P4ulBr4ndt/hellen-bremen/README.md

# Hellen-Bremen

**WIP. Untested.**

This is trying to be yet another HD ECU based on rusEFI.\
Commercial rusEFI based HD ECUs:\
https://www.nmstec.ca/product/hdrevb/ This seems to be the initial community development? 
https://impactwiringsolutions.com/ Commercial product
