P4ulBr4ndt/hellen-bremen/boards/hellenbremen-a/board/hellenbremen-a.png

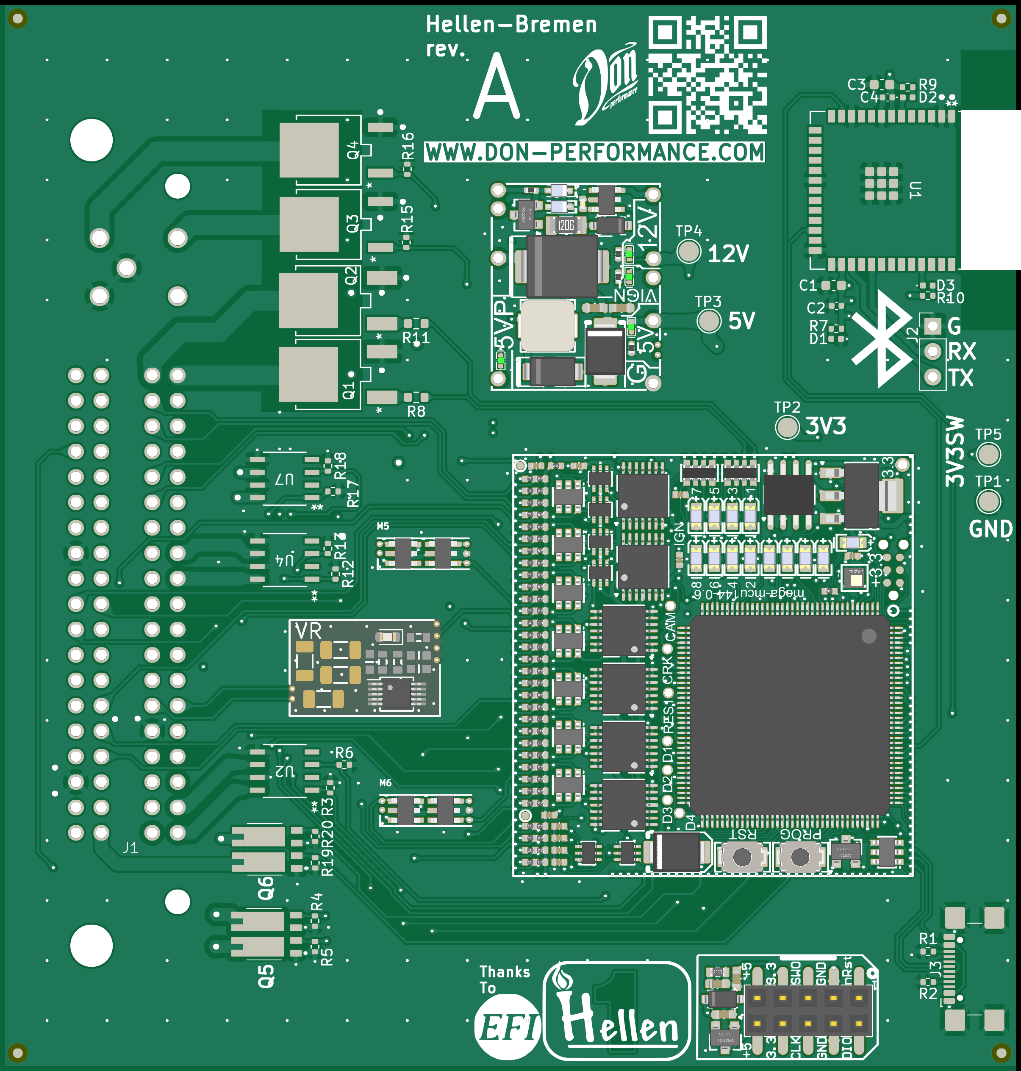
boards/hellenbremen-a/board/hellenbremen-a.png
