P4ulBr4ndt/hellen-bremen/boards/hellenbremen-a/board/misc/hellenbremen-a-bottom.png

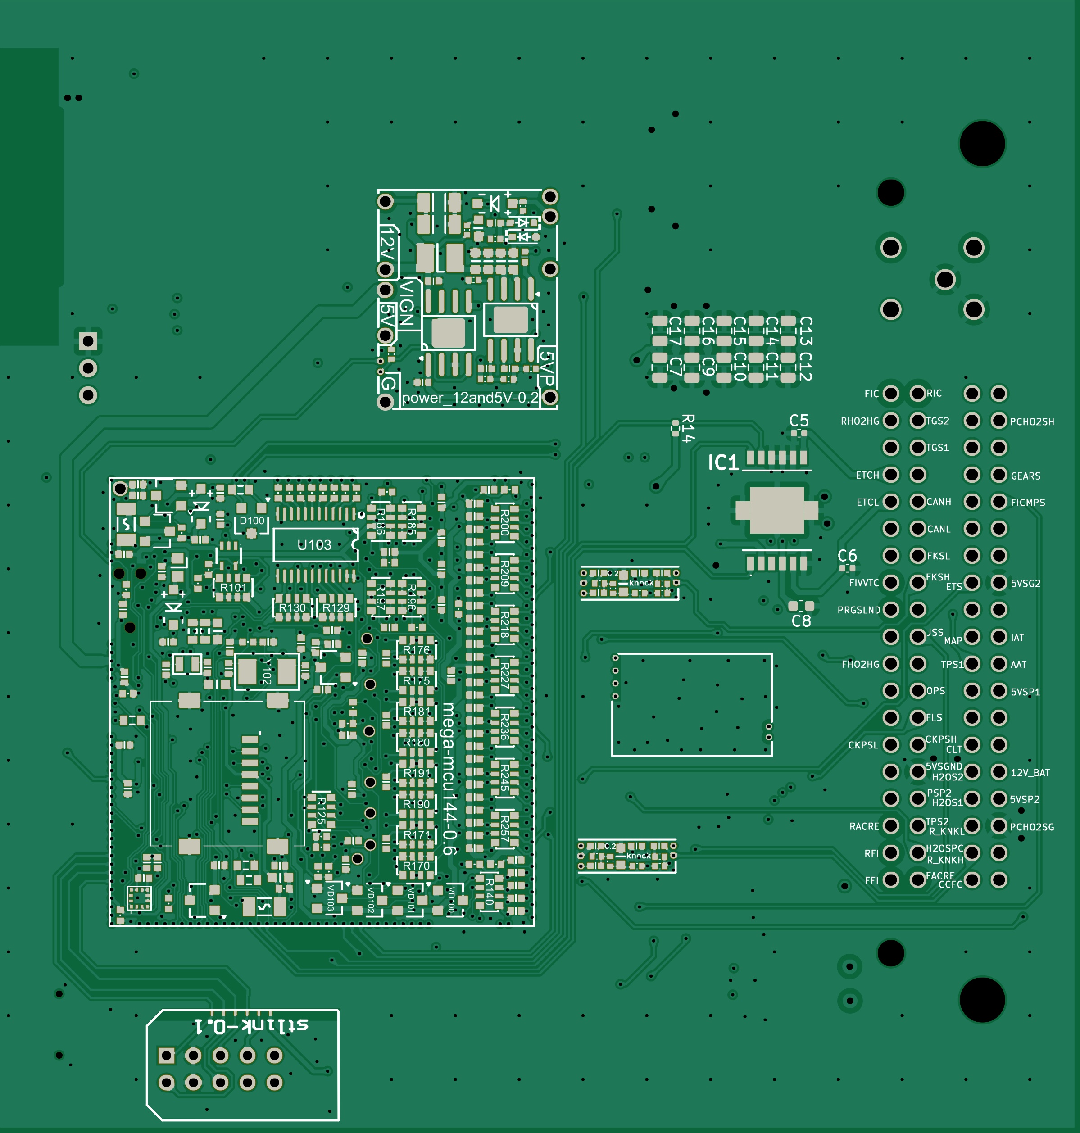
boards/hellenbremen-a/board/misc/hellenbremen-a-bottom.png
