P4ulBr4ndt/hellen-bremen/boards/hellenbremen-a/board/misc/hellenbremen-a-outline.png

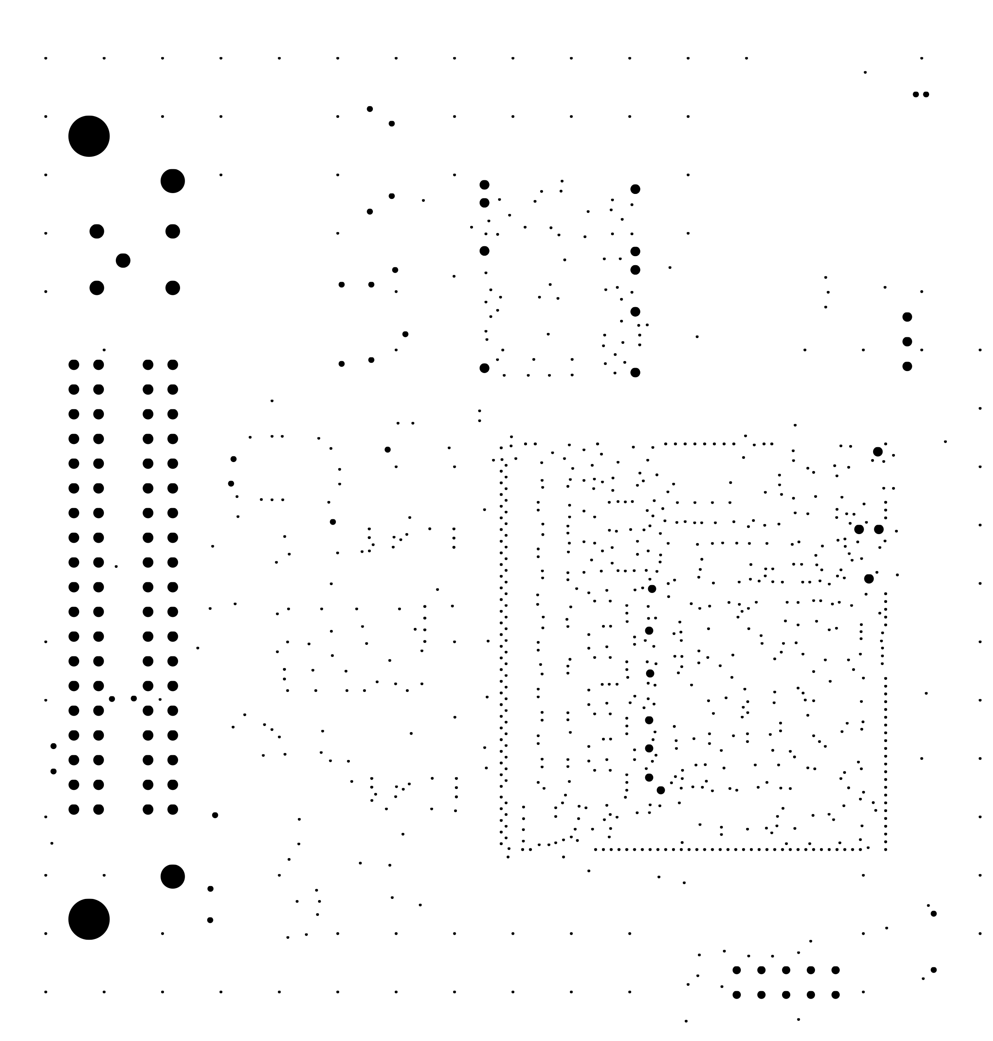
boards/hellenbremen-a/board/misc/hellenbremen-a-outline.png
