P4ulBr4ndt/hellen-bremen/boards/hellenbremen-c/board/misc/hellenbremen-c-components.png

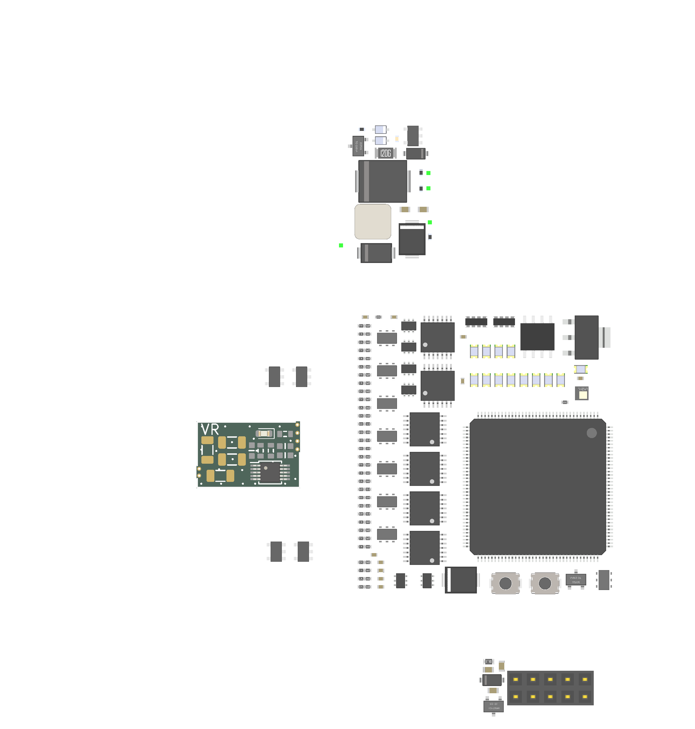
boards/hellenbremen-c/board/misc/hellenbremen-c-components.png
