P4ulBr4ndt/hellen-bremen/boards/hellenbremen-c/frame/bremen-schematic.pdf

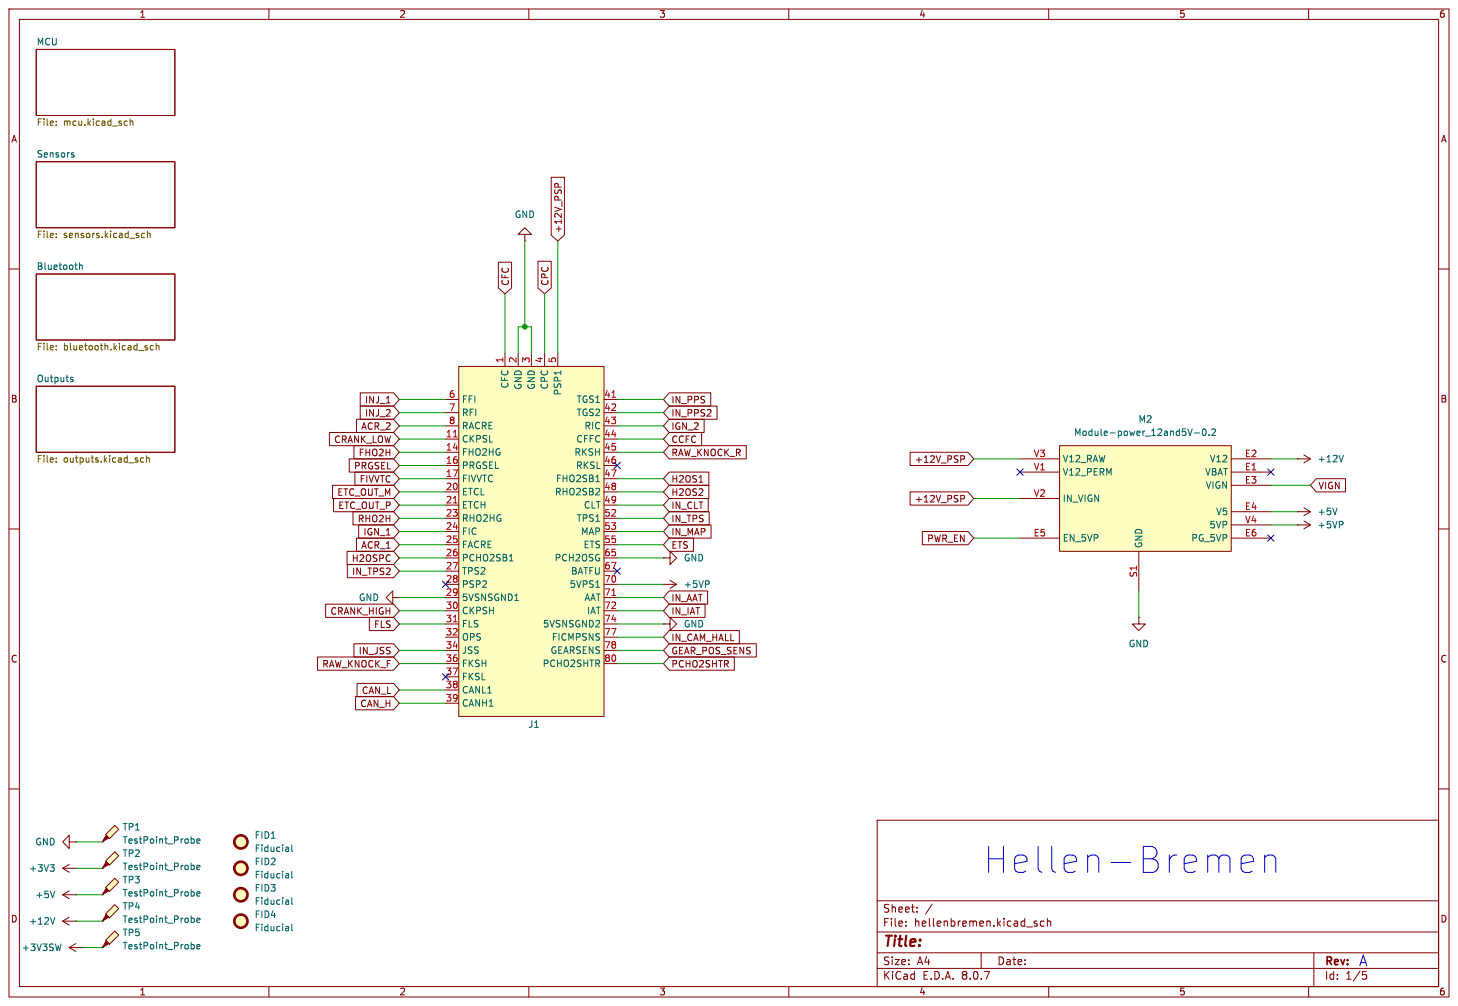
[picture p6: page 1]

File: mcu.kicad_sch Bluetooth File: bluetooth.kicad_sch Outputs File: outputs.kicad_sch Sensors File: sensors.kicad_sch

1 CKPSL 11 FHO2HG 14 PRGSEL 16 FIVVTC 17 GND

2 ETCL 20 ETCH 21 RHO2HG 23 FIC 24 FACRE 25 PCHO2SB1 26 TPS2 27 PSP2 28

5 TPS1 52 MAP 53 ETS 55 FFI 6 PCH2OSG 65 BATFU 67 RFI 7

4 TGS1 41 TGS2 42 RIC 43 CFFC 44 RKSH 45 RKSL 46 FHO2SB1 47 RHO2SB2 48 CLT 49 PSP1

Id: 1/5 Title: File: hellenbremen.kicad_sch Sheet: /

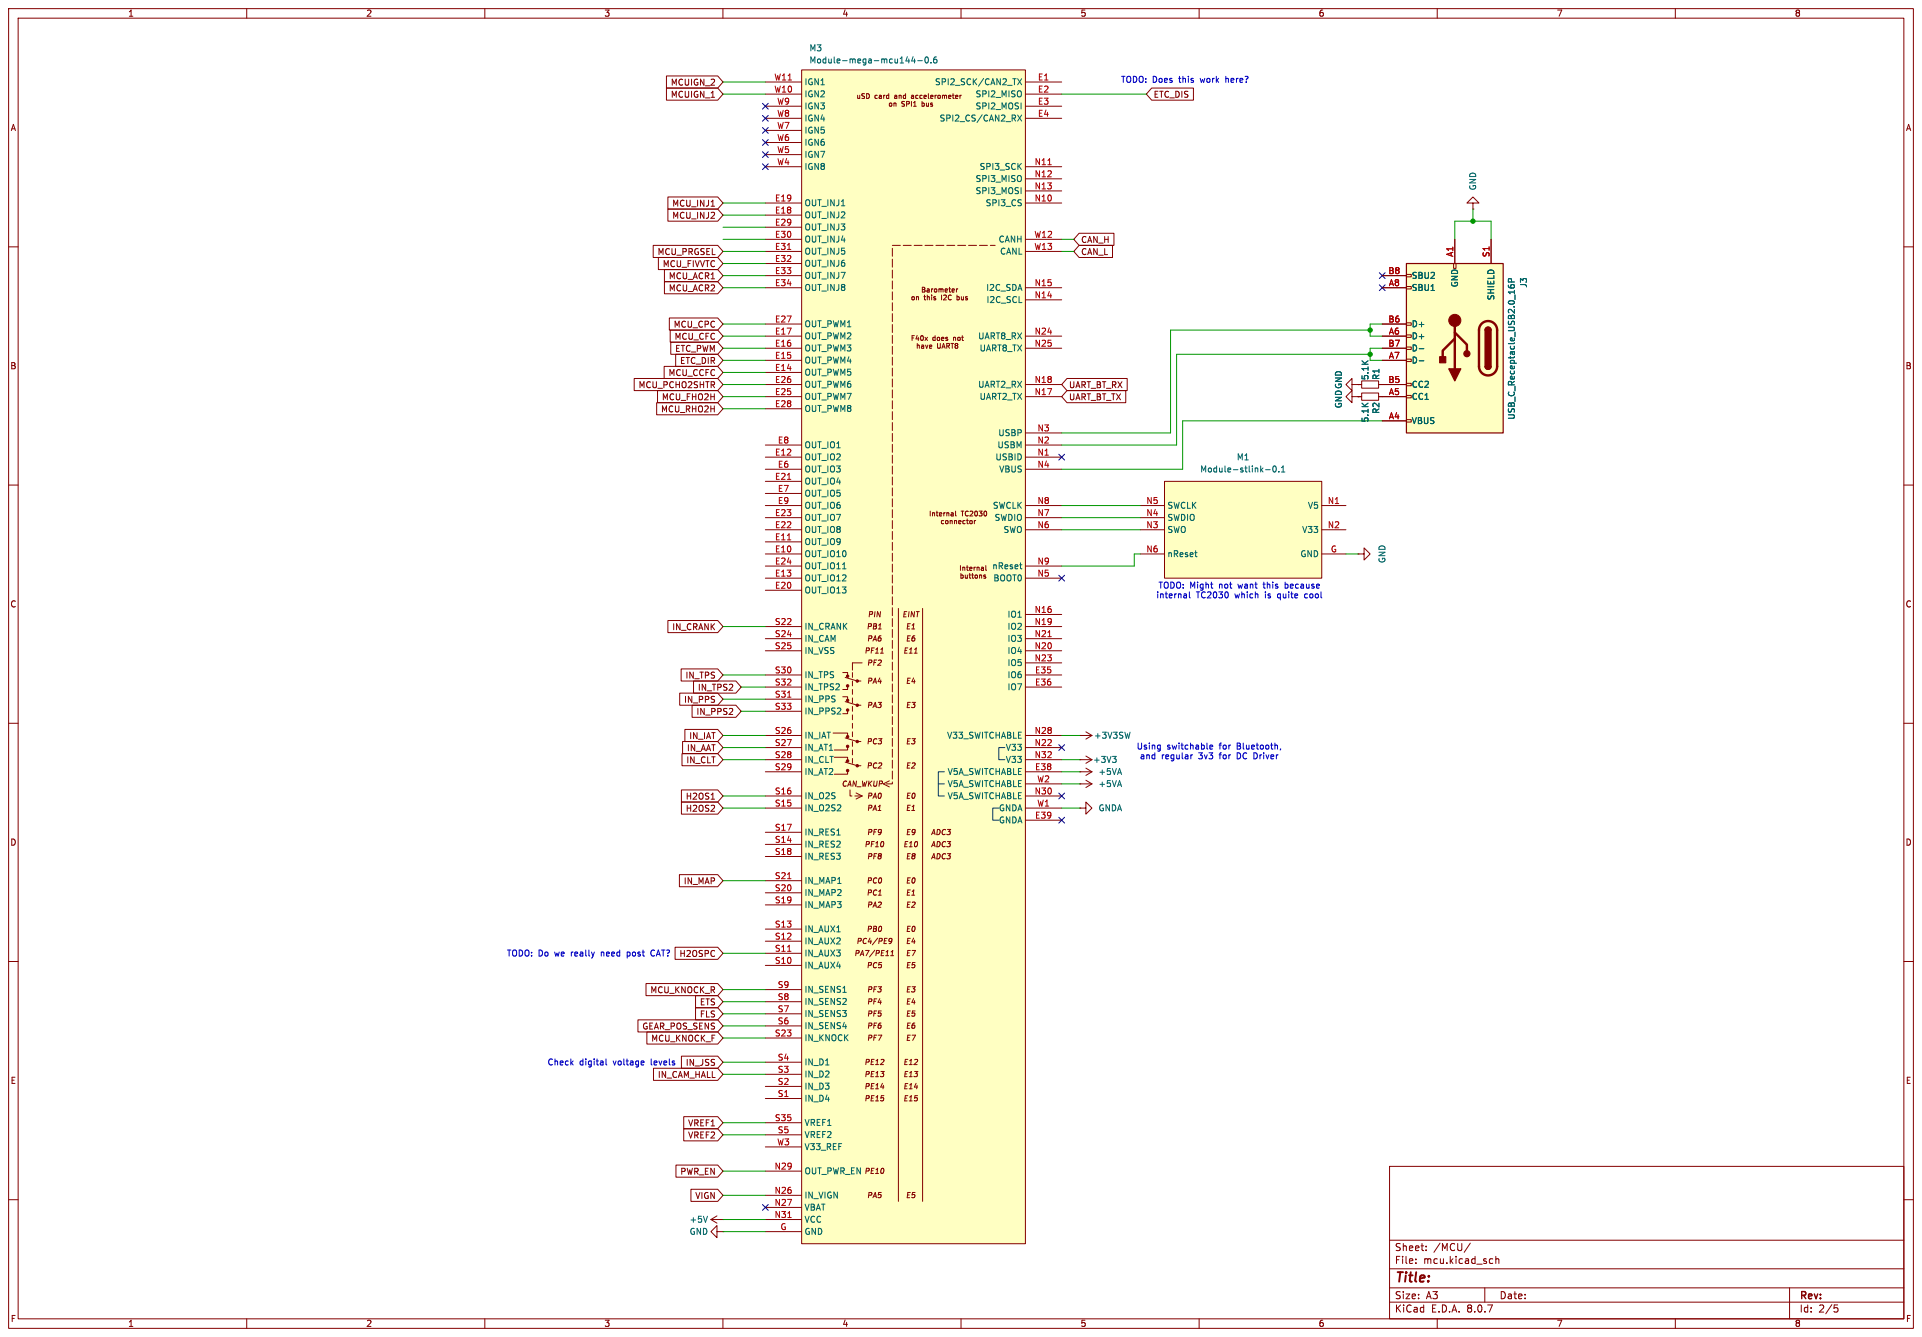
[picture p7: page 2]

TODO: Does this work here? TODO: Might not want this because
connector PA0 PA1 PA2 PA3 PA4

Id: 2/5 Title: File: mcu.kicad_sch Sheet: /MCU/

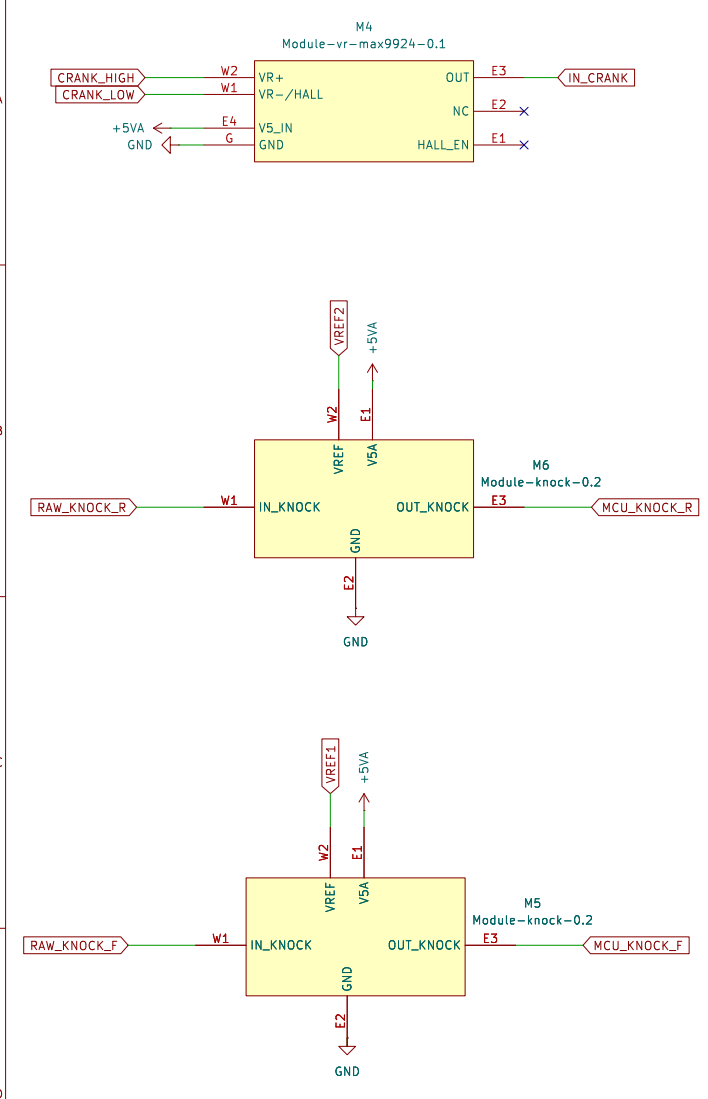
[picture p8: page 3]

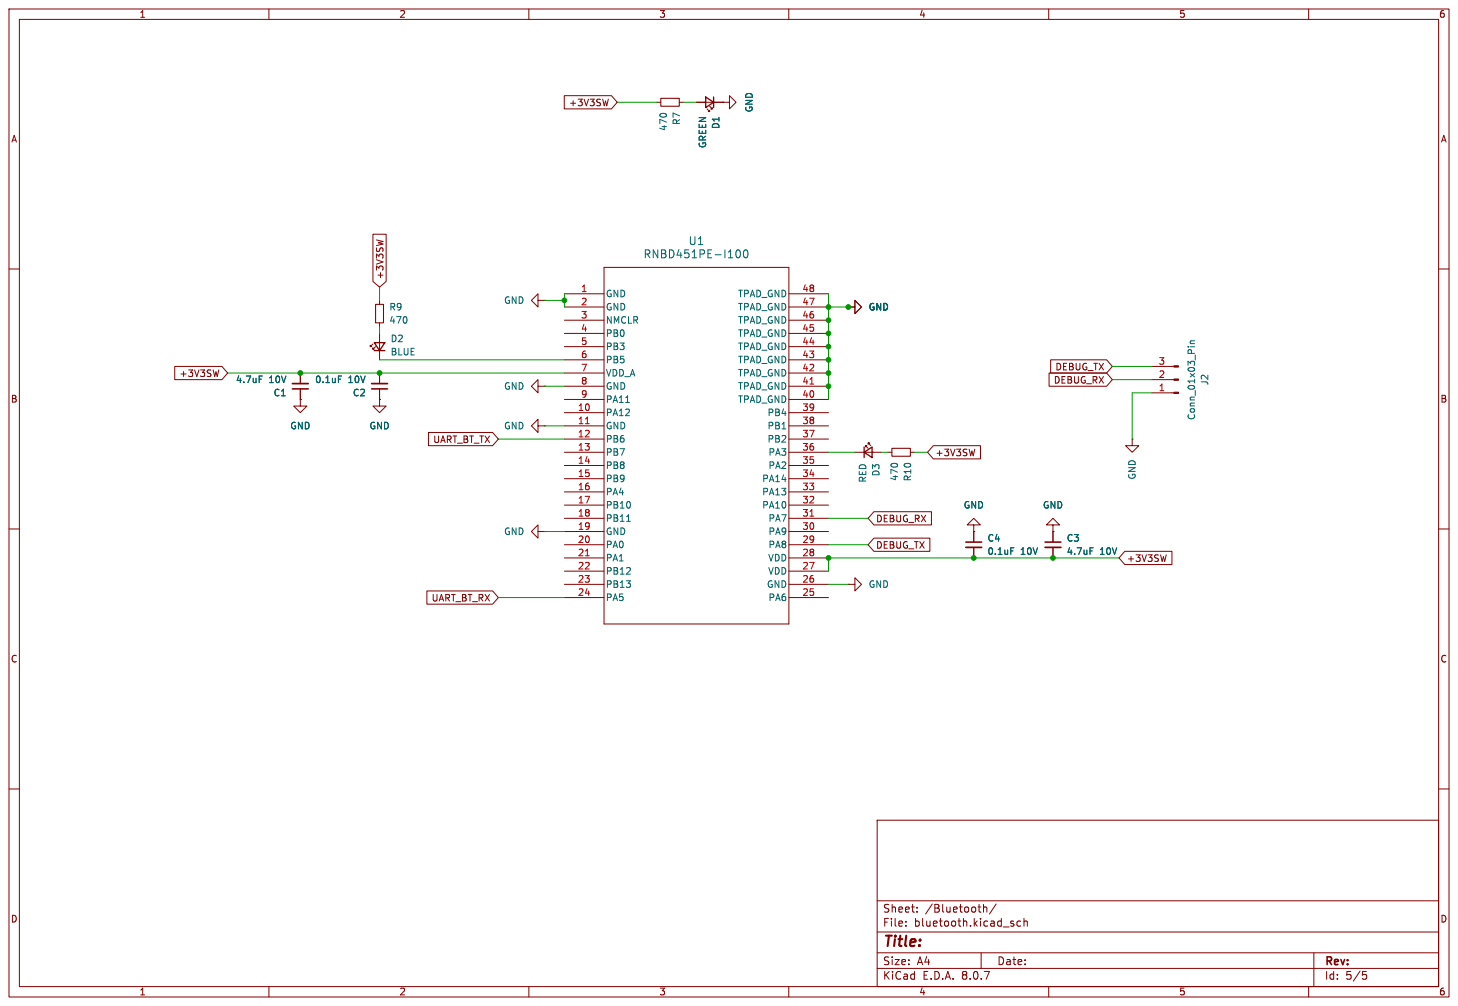
[picture p9: page 4]

Id: 5/5 Title: File: bluetooth.kicad_sch Sheet: /Bluetooth/ GND

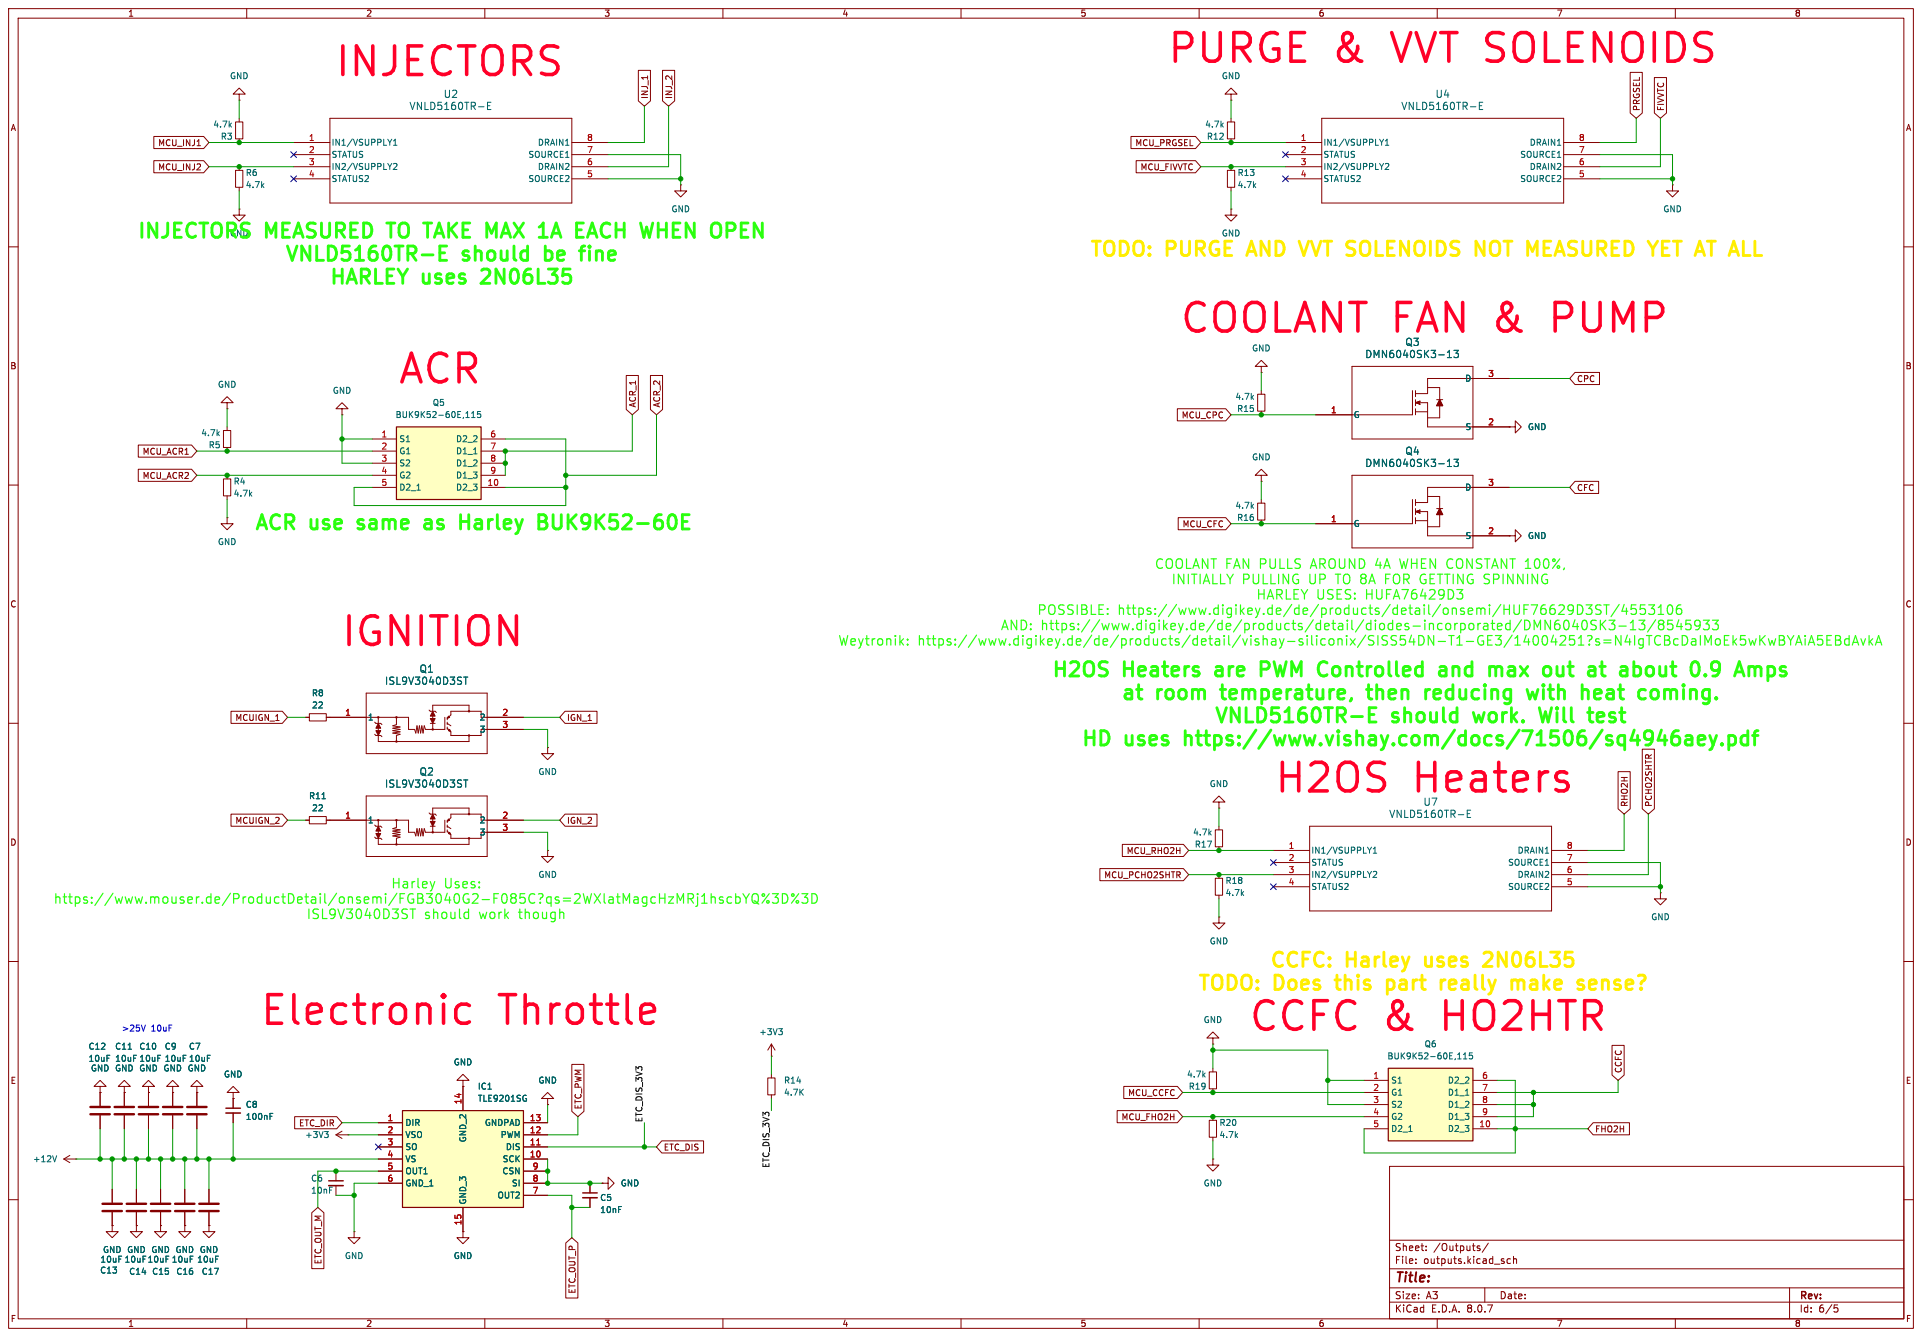
[picture p10: page 5]

INJECTORS MEASURED TO TAKE MAX 1A EACH WHEN OPEN

TODO: PURGE AND VVT SOLENOIDS NOT MEASURED YET AT ALL
COOLANT FAN & PUMP

COOLANT FAN PULLS AROUND 4A WHEN CONSTANT 100%,
INITIALLY PULLING UP TO 8A FOR GETTING SPINNING

POSSIBLE: https://www.digikey.de/de/products/detail/onsemi/HUF76629D3ST/4553106
AND: https://www.digikey.de/de/products/detail/diodes-incorporated/DMN6040SK3-13/8545933
H2OS Heaters are PWM Controlled and max out at about 0.9 Amps

Weytronik: https://www.digikey.de/de/products/detail/vishay-siliconix/SISS54DN-T1-GE3/14004251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

HD uses https://www.vishay.com/docs/71506/sq4946aey.pdf

https://www.mouser.de/ProductDetail/onsemi/FGB3040G2-F085C?qs=2WXlatMagcHzMRj1hscbYQ%3D%3D

TODO: Does this part really make sense?

Id: 6/5 Title: File: outputs.kicad_sch Sheet: /Outputs/ C10
10uF GND
10nF GND
