P4ulBr4ndt/hellen-bremen/boards/hellenbremen-a/board/hellenbremen-a-schematic.pdf

File: mcu.kicad_sch Bluetooth File: bluetooth.kicad_sch Outputs File: outputs.kicad_sch Sensors File: sensors.kicad_sch

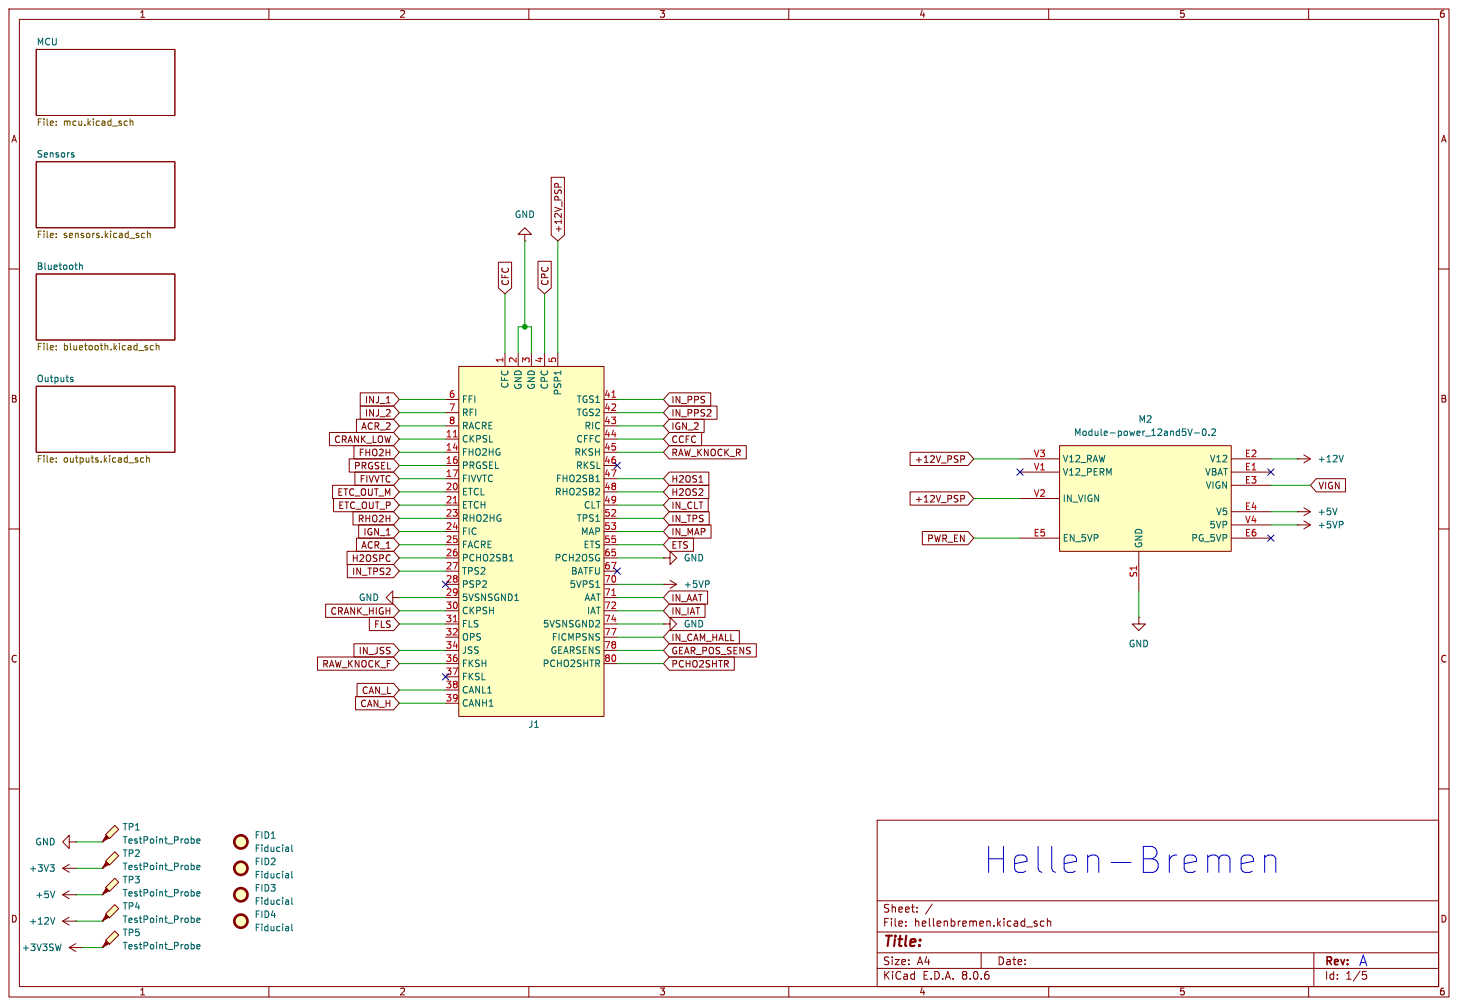
[picture p30: page 1]
D Date: KiCad; E.D.A. 8.0.6 Size: A4; Rev:; MCU; FID4 Fiducial GND; TP2 TestPoint_Probe TP1 TestPoint_Probe TP3 TestPoint_Probe; GND; GND CFC; 5VSNSGND1 29; JSS 34 FKSH 36 FKSL 37 CANL1 38 CANH1 39; CPC; 5VPS1 70 AAT 71; IAT 72; 5VSNSGND2 74 FICMPSNS 77 GEARSENS 78 RACRE 8; PCHO2SHTR 80; +5VP GND; TP5 TestPoint_Probe; VBAT; E2 VIGN; E6 GND S¹ V12_PERM V1; IN_VIGN V2; V12_RAW V3; V4 M2 Module-power_12and5V-0.2; TP4 TestPoint_Probe; FID2 Fiducial FID3 Fiducial FID1 Fiducial +12V; RHO2H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

1 CKPSL 11 FHO2HG 14 PRGSEL 16 FIVVTC 17 GND

2 ETCL 20 ETCH 21 RHO2HG 23 FIC 24 FACRE 25 PCHO2SB1 26 TPS2 27 PSP2 28

3 CKPSH 30 FLS 31 OPS 32

5 TPS1 52 MAP 53 ETS 55 FFI 6 PCH2OSG 65 BATFU 67 RFI 7

4 TGS1 41 TGS2 42 RIC 43 CFFC 44 RKSH 45 RKSL 46 FHO2SB1 47 RHO2SB2 48 CLT 49 PSP1

Id: 1/5 Title: File: hellenbremen.kicad_sch Sheet: /

on | this I2C bus CAN_WKUP
USBID | N1 SPI3_CS | N10 SPI3_SCK | N11 SPI3_MISO | N12 SPI3_MOSI | N13

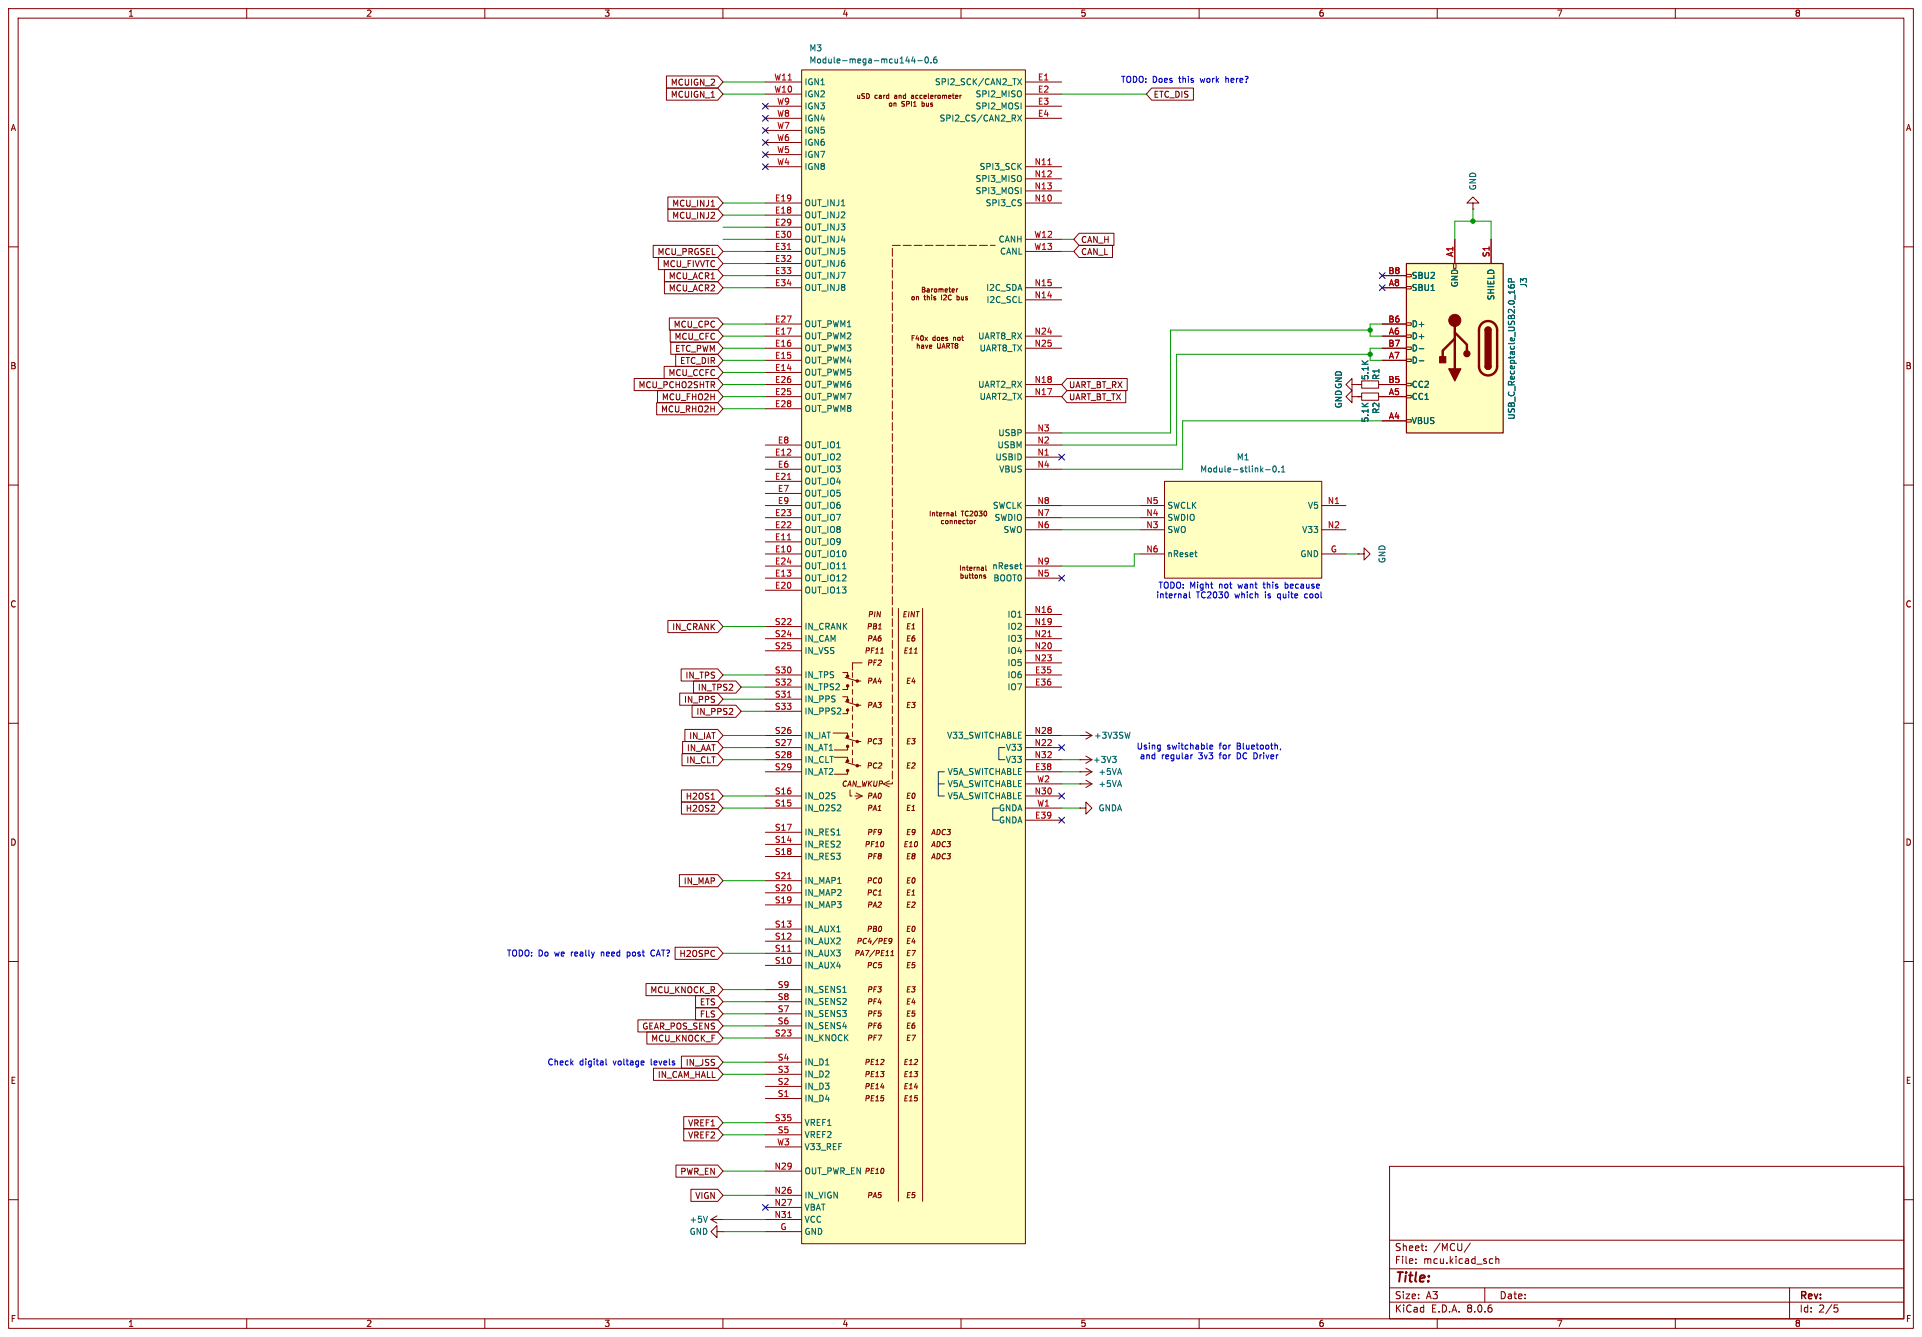
[picture p31: page 2]
8 ABCDEF; ABCDEF Date: KiCad; E.D.A. 8.0.6 Size: A3; Rev:; GND; GNDA; ADC3 ADC3 ADC3; Barometer; E6E7E7E8E9 EINT; F40x does not; have; UART8; Internal; buttons; PA6 PA7/PE11 PB0 PB1 PC0 PC1 PC2 PC3 PC4/PE9 PC5 PE10 PE12 PE13 PE14 PE15 PF10 PF11 PF2 PF3 PF4 PF5 PF6 PF7 PF8 PF9 PIN; uSD card and accelerometer; SPI1 bus SPI2_SCK/CAN2_TX; E1 OUT_IO10 E10; OUT_IO9 E11; OUT_IO2 E12; OUT_IO12 E13; OUT_PWM5 E14; OUT_PWM4 E15; OUT_PWM3 E16; OUT_PWM2 E17; OUT_INJ2 E18; OUT_INJ1 E19; SPI2_MISO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

TODO: Does this work here? TODO: Might not want this because
connector PA0 PA1 PA2 PA3 PA4

V5 N1 V33 N2 SWO N3 SWDIO N4 SWCLK N5

Id: 2/5 Title: File: mcu.kicad_sch Sheet: /MCU/

+5VA | +5VA GNDGND ⁺⁵VA | HALL_EN | E1 NC | E2 OUT | E3 V5_IN E4 | GND G

# IN_CRANK MCU_KNOCK_R

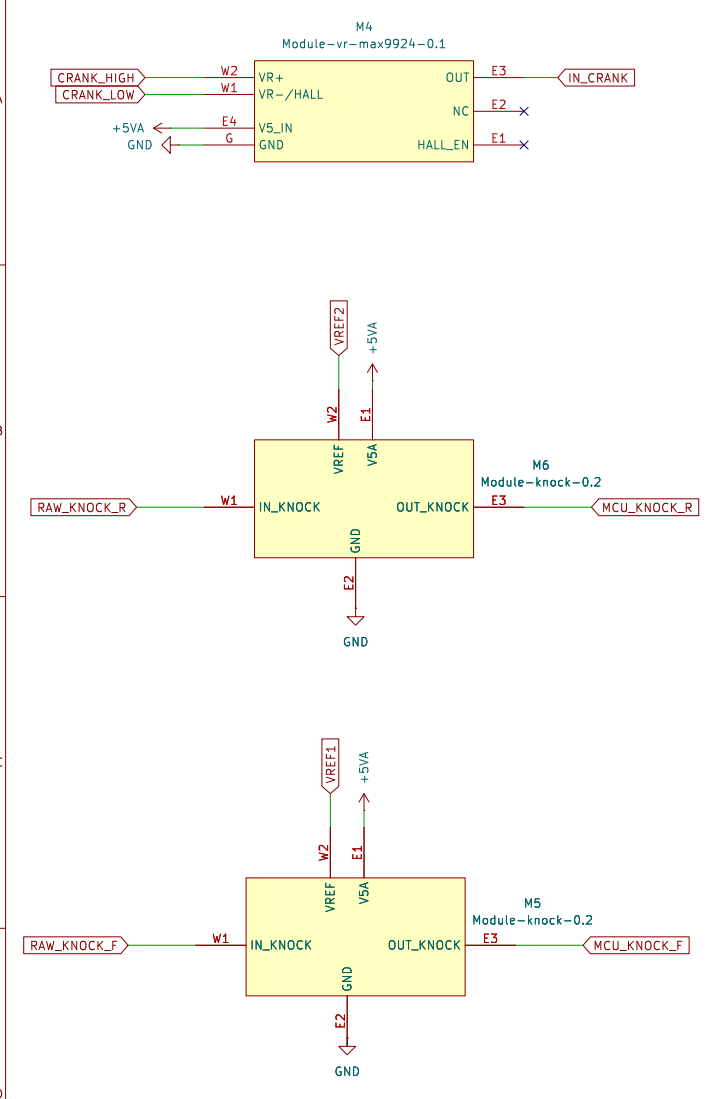
[picture p32: page 3]
D Date: KiCad; E.D.A. 8.0.6 Size: A4; Rev:; Id: 4/5 Title: File: sensors.kicad_sch Sheet: /Sensors/ V⁵A E¹ GND E²; OUT_KNOCK; E3 IN_KNOCK W1; VREF W²; M6 Module-knock-0.2 GND; VR-/HALL W1; M4 Module-vr-max9924-0.1 V⁵A E¹ GND E²; M5 Module-knock-0.2 VREF2 RAW_KNOCK_F; VREF1; CRANK_LOW; CRANK_HIGH; MCU_KNOCK_F RAW_KNOCK_R; GND; M6 Module-knock-0.2 V⁵A E¹ GND E²; VREF W² GND; M5 Module-knock-0.2 V⁵A E¹ GND E²

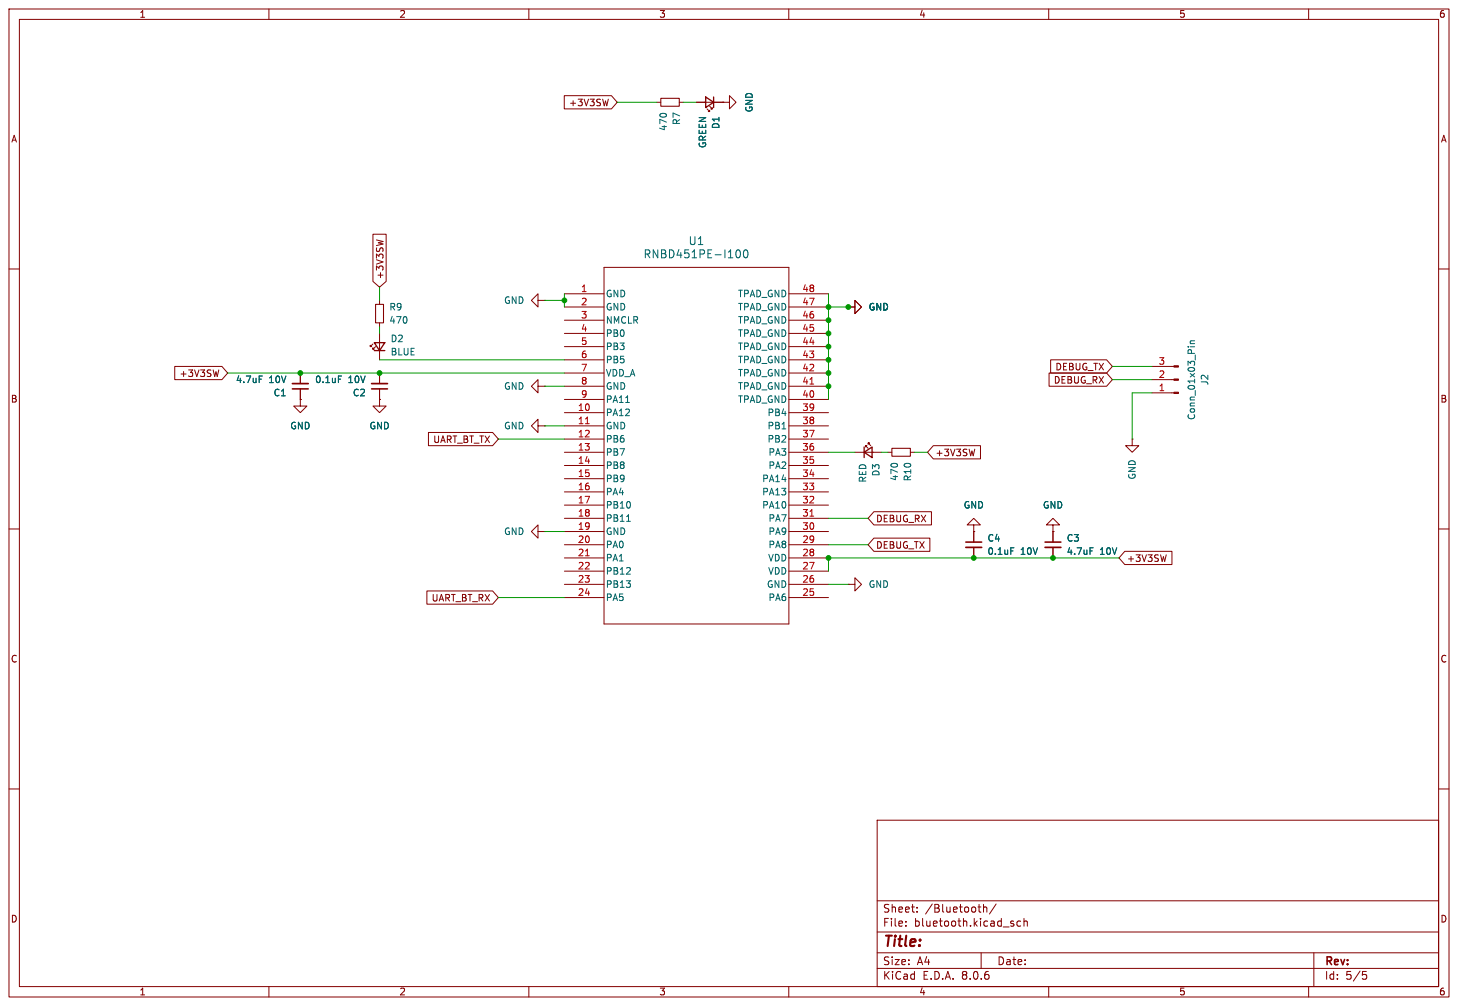
[picture p33: page 4]
D Date: KiCad; E.D.A. 8.0.6 Size: A4; Rev:; GND GND; D¹ GREENR⁷ 470; GND; 470 R¹⁰ D³ RED; 0.1uF 10V GND; J2 Conn_01x03_Pin GND; 4.7uF 10V GND 1; GND 11; GND 19; GND 2; 25 GND; 26 VDD; 27 VDD; 29 NMCLR 3; TPAD_GND; 40 TPAD_GND; 41 TPAD_GND; 42 TPAD_GND; 43 TPAD_GND; 44 TPAD_GND; 45 TPAD_GND; 46 TPAD_GND; 47 TPAD_GND; VDD_A 7; GND 8; U1 RNBD451PE-I100 GND; D2BLUE GND; DEBUG_RX; +3V³SW; DEBUG_TX; DEBUG_RX DEBUG_TX UART_BT_TX; UART_BT_RX GND; D¹ GREEN

Id: 5/5 Title: File: bluetooth.kicad_sch Sheet: /Bluetooth/ GND

# GND GND

4.7k R5

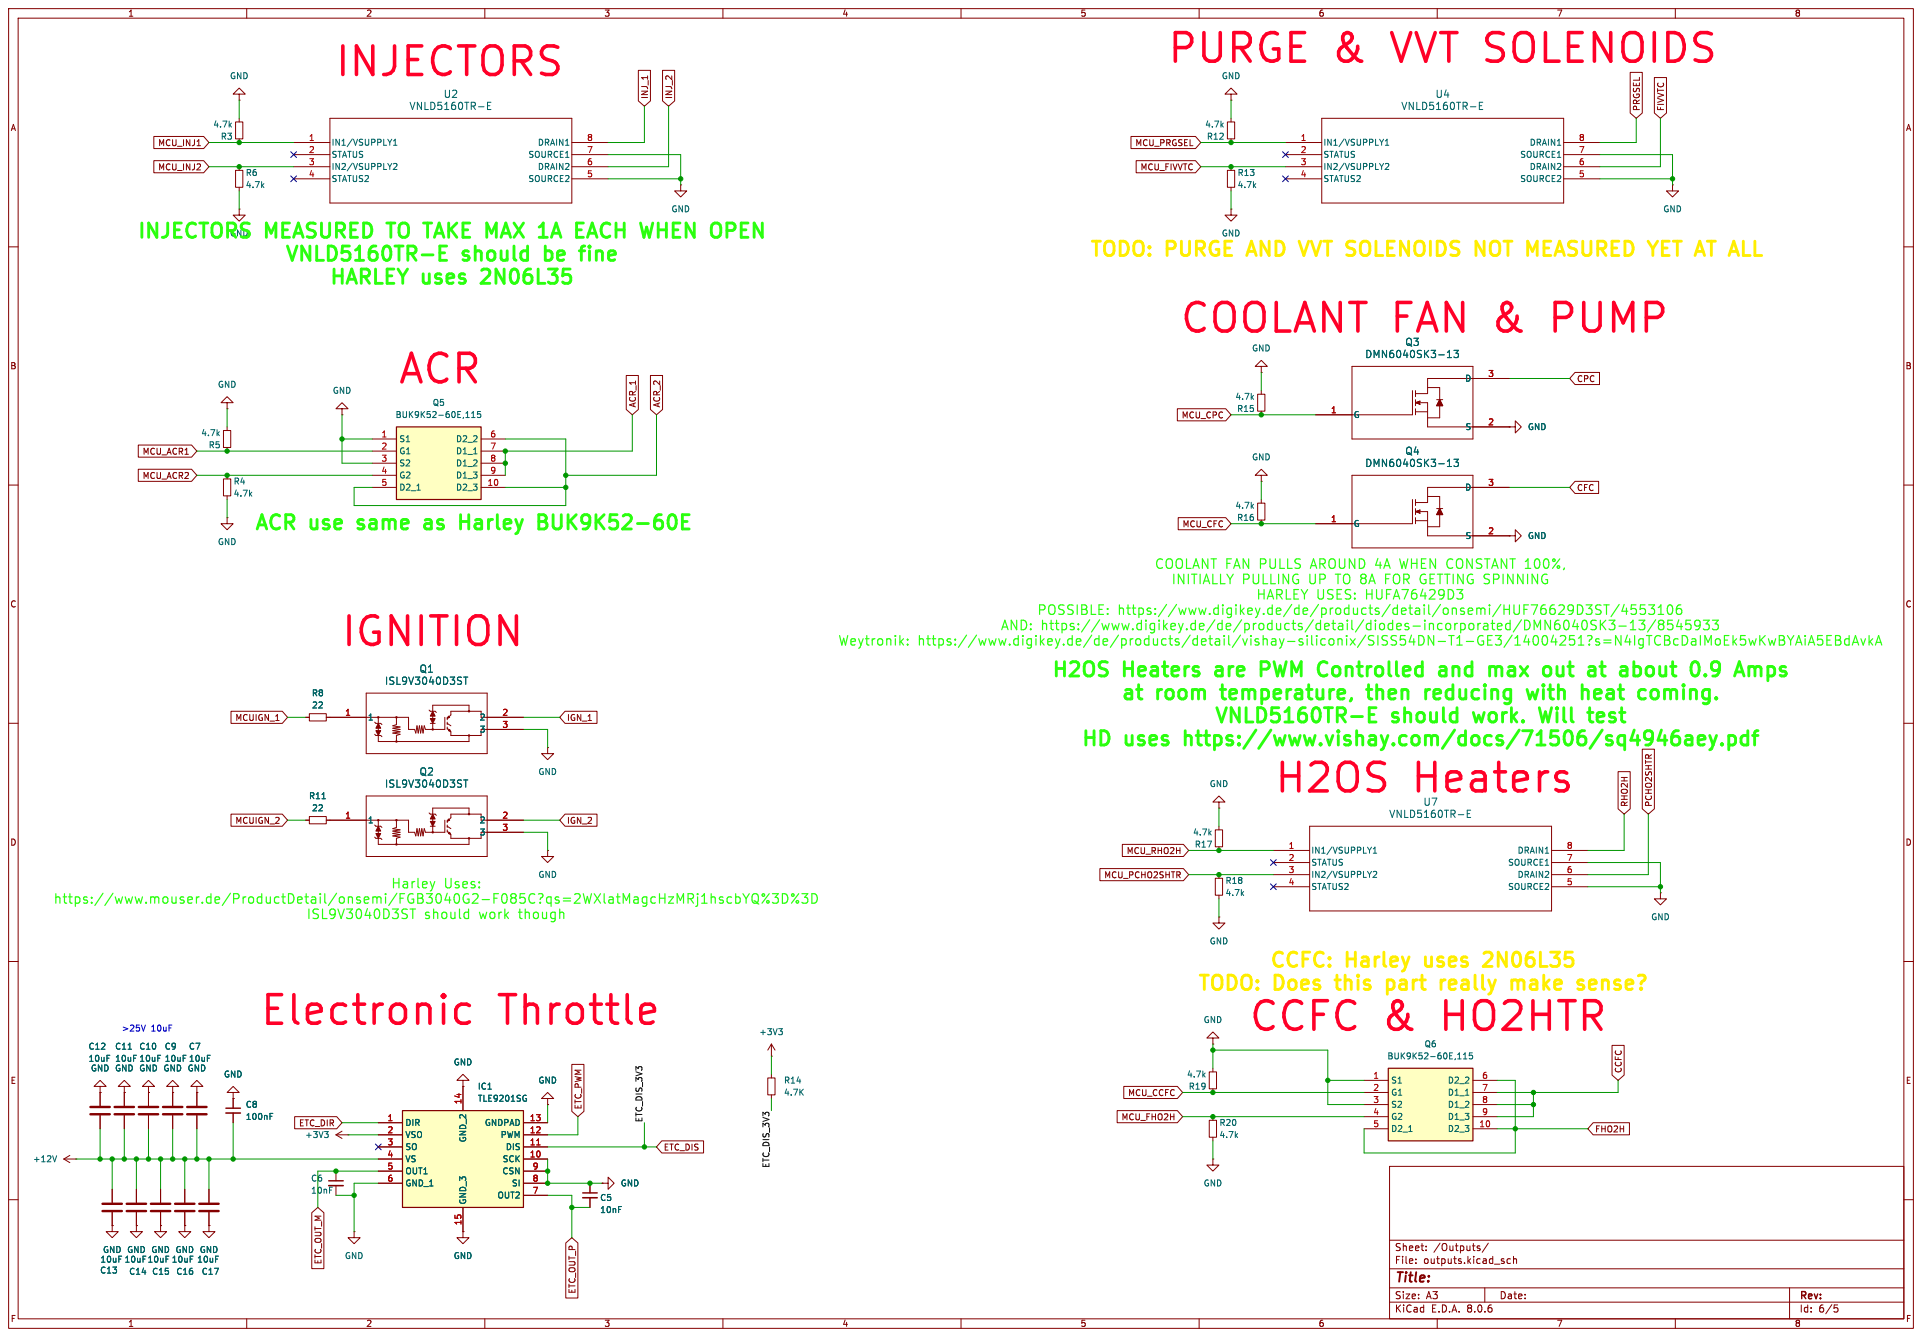
[picture p34: page 5]

INJECTORS MEASURED TO TAKE MAX 1A EACH WHEN OPEN

TODO: PURGE AND VVT SOLENOIDS NOT MEASURED YET AT ALL
COOLANT FAN & PUMP

COOLANT FAN PULLS AROUND 4A WHEN CONSTANT 100%,
INITIALLY PULLING UP TO 8A FOR GETTING SPINNING

POSSIBLE: https://www.digikey.de/de/products/detail/onsemi/HUF76629D3ST/4553106
AND: https://www.digikey.de/de/products/detail/diodes-incorporated/DMN6040SK3-13/8545933
H2OS Heaters are PWM Controlled and max out at about 0.9 Amps

Weytronik: https://www.digikey.de/de/products/detail/vishay-siliconix/SISS54DN-T1-GE3/14004251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

HD uses https://www.vishay.com/docs/71506/sq4946aey.pdf

https://www.mouser.de/ProductDetail/onsemi/FGB3040G2-F085C?qs=2WXlatMagcHzMRj1hscbYQ%3D%3D

TODO: Does this part really make sense?

Id: 6/5 Title: File: outputs.kicad_sch Sheet: /Outputs/ C10
10uF GND
10nF GND

andreika; Size:; Author:; Date:; Revision:; Sheet; nReset 1; SWDIO; GND 3; GND; SWO 5; SWCLK; ST/Link 2x5; nReset; SWO; 2 OUT 3; SWO N3; SWDIO N4; N1 SWCLK N5; nReset N6; Module:stlink/0.1; SWDIO SWO

Hellen-One ST-Link
Title:

rusEFI EMS
Hellen-One Platform
https://rusefi.com/s/hellen72


Hellen One : Power-Module interface

Reverse polarity and overvoltage protection
F410 V12_RAW

Vdd 4; Vss 6; MCP6004; GNDA; OUT1; OUT2; OUT3; OUT4; C170 PIC17001 100n; PIC17002 COC3; PIR17001; PIR17002; PIR17003; PIR17004; PIR17005; PIR17006; PIR17007; PIR17008; COR5; PIR17101; PIR17102; PIR17103; PIR17105; PIR17104; PIR17106; PIR17107; PIR17108; COR6; PIU17001; PIU17002; PIU17003; PIU17004; PIU17005; PIU17006; PIU17007; PIU17008; PIU17009; PIU170010; PIU170011; PIU170012; PIU170013; PIU170014; COU2; PIC17001; POOUT2; POOUT1; POOUT3; POOUT4; POIN1; POIN3 PIU17005; PIU170010 POIN4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

D | D
C | C
B | B
A | A

C270
100n

V5A

IO0
IO1

COM

MUX

B1 1

GND | 2
B0 3 | A | 4

VCC 5

S 6

U270

NC7SB3157P6X

GNDA | GNDA

PIC27001

# PIC27002 COC125

PIU27001

PIU27002

PIU27003 | PIU27004

PIU27005

PIU27006

## COU104

PIC27001

PIU27002

POIO1 PIU27001

POIO0 PIU27003 | PIU27004 POCOM

PIU27006 POMUX

# PIC27002 PIU27005

POIO00Mux1 | POCOM0Mux1
POIO10Mux1 | POMUX0Mux1

Vdd 4; Vss 6; MCP6004; GNDA; OUT1; OUT2; OUT3; OUT4; C175 PIC17501 100n; PIC17502 COC3; PIR17501; PIR17502; PIR17503; PIR17504; PIR17505; PIR17506; PIR17507; PIR17508; COR5; PIR17601; PIR17602; PIR17603; PIR17605; PIR17604; PIR17606; PIR17607; PIR17608; COR6; PIU17501; PIU17502; PIU17503; PIU17504; PIU17505; PIU17506; PIU17507; PIU17508; PIU17509; PIU175010; PIU175011; PIU175012; PIU175013; PIU175014; COU2; PIC17501; POOUT2; POOUT1; POOUT3; POOUT4; POIN1; POIN3 PIU17505; PIU175010 POIN4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

D | D
C | C
B | B
A | A

C275
100n

V5A

IO0
IO1

COM

MUX

B1 1

GND | 2
B0 3 | A | 4

VCC 5

S 6

U275

NC7SB3157P6X

GNDA | GNDA

PIC27501

# PIC27502 COC125

PIU27501

PIU27502

PIU27503 | PIU27504

PIU27505

PIU27506

## COU104

PIC27501

PIU27502

POIO1 PIU27501

POIO0 PIU27503 | PIU27504 POCOM

PIU27506 POMUX

# PIC27502 PIU27505

POIO00Mux2 | POCOM0Mux2
POIO10Mux2 | POMUX0Mux2

Vdd 4; Vss 6; MCP6004; GNDA; OUT1; OUT2; OUT3; OUT4; C180 PIC18001 100n; PIC18002 COC3; PIR18001; PIR18002; PIR18003; PIR18004; PIR18005; PIR18006; PIR18007; PIR18008; COR5; PIR18101; PIR18102; PIR18103; PIR18105; PIR18104; PIR18106; PIR18107; PIR18108; COR6; PIU18001; PIU18002; PIU18003; PIU18004; PIU18005; PIU18006; PIU18007; PIU18008; PIU18009; PIU180010; PIU180011; PIU180012; PIU180013; PIU180014; COU2; PIC18001; POOUT2; POOUT1; POOUT3; POOUT4; POIN1; POIN3 PIU18005; PIU180010 POIN4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

D | D
C | C
B | B
A | A

C280
100n

V5A

IO0
IO1

COM

MUX

B1 1

GND | 2
B0 3 | A | 4

VCC 5

S 6

U280

NC7SB3157P6X

GNDA | GNDA

PIC28001

# PIC28002 COC125

PIU28001

PIU28002

PIU28003 | PIU28004

PIU28005

PIU28006

## COU104

PIC28001

PIU28002

POIO1 PIU28001

POIO0 PIU28003 | PIU28004 POCOM

PIU28006 POMUX

# PIC28002 PIU28005

POIO00Mux3 | POCOM0Mux3
POIO10Mux3 | POMUX0Mux3

Vdd 4; Vss 6; MCP6004; GNDA; OUT1; OUT2; OUT3; OUT4; C185 PIC18501 100n; PIC18502 COC3; PIR18501; PIR18502; PIR18503; PIR18504; PIR18505; PIR18506; PIR18507; PIR18508; COR5; PIR18601; PIR18602; PIR18603; PIR18605; PIR18604; PIR18606; PIR18607; PIR18608; COR6; PIU18501; PIU18502; PIU18503; PIU18504; PIU18505; PIU18506; PIU18507; PIU18508; PIU18509; PIU185010; PIU185011; PIU185012; PIU185013; PIU185014; COU2; PIC18501; POOUT2; POOUT1; POOUT3; POOUT4; POIN1; POIN3 PIU18505; PIU185010 POIN4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

D | D
C | C
B | B
A | A

C285
100n

V5A

IO0
IO1

COM

MUX

B1 1

GND | 2
B0 3 | A | 4

VCC 5

S 6

U285

NC7SB3157P6X

GNDA | GNDA

PIC28501

# PIC28502 COC125

PIU28501

PIU28502

PIU28503 | PIU28504

PIU28505

PIU28506

## COU104

PIC28501

PIU28502

POIO1 PIU28501

POIO0 PIU28503 | PIU28504 POCOM

PIU28506 POMUX

# PIC28502 PIU28505

POIO00Mux4 | POCOM0Mux4
POIO10Mux4 | POMUX0Mux4

Vdd 4; Vss 6; MCP6004; GNDA; OUT1; OUT2; OUT3; OUT4; C190 PIC19001 100n; PIC19002 COC3; PIR19001; PIR19002; PIR19003; PIR19004; PIR19005; PIR19006; PIR19007; PIR19008; COR5; PIR19101; PIR19102; PIR19103; PIR19105; PIR19104; PIR19106; PIR19107; PIR19108; COR6; PIU19001; PIU19002; PIU19003; PIU19004; PIU19005; PIU19006; PIU19007; PIU19008; PIU19009; PIU190010; PIU190011; PIU190012; PIU190013; PIU190014; COU2; PIC19001; POOUT2; POOUT1; POOUT3; POOUT4; POIN1; POIN3 PIU19005; PIU190010 POIN4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

SPI_; VCC; 5 SPI_SCK; 7 SPI_O; lex MicroSD; _MIS


R143 populated: analog input O2S
R145 populated: WAKEUP by CAN

D5 *D5 is digital-only on F429! (EINT11)

*VIGN input is unprotected!




D100 PESD1CAN; GND; TXD 1 GND 2 VCC 3; Vio; 5 RXD 4; CANL; 6 CANH; TJA1051T/3/1J; CAN_TX; CAN_RX; VCC; CANH; CANL C100 100n

VRE; _CRA; _CLT; IAT; _IAT; _PPS; VIG; nRes; VBAT; SWCL; SPI2; _MIS; SPI3; I2C_SCL; SPI1; u mcu.Sch; _IGN; 8.Sch; _can can.Sch; d.Sch; nRS; x.Sch; USB_; P USB_; USBI; A I2C_SCL UART8_RX UART8_TX UART2_RX UART2_TX; N VBAT; VCC; ACC_SC; ACC_; ACC_MIS; ACC_MO; BARO; sen; ors.Sc; LVC1; PWR_; VBU; wer.Sch; USBM; USBP; 6 SWDIO; N7 SWCLK; N8 nReset; 4 I2C_SDA; VREF2 S5; IN_SENS3 S7; IN_SENS2 S8; IN_SENS1 S9; IN_AUX3 S11; IN_AUX2 S12; IN_AUX1 S13; IN_MAP2 S20; IN_MAP1 S21; IAT S26; _CLT S28; IN_TPS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

USBM USBP USBID VBUS

### COR2

Vdd 4; Vss 6; MCP6004; GNDA; IN1 (CRNK); OUT1; OUT2; OUT3; OUT4; C195 PIC19501 100n; PIC19502 COC2; PIR19502; PIR19501; PIR19601; PIR19602; PIR19603; PIR19604; PIR19605; PIR19606; PIR19607; PIR19608; COR3; PIR19701; PIR19702; PIR19703; PIR19705; PIR19704; PIR19706; PIR19707; PIR19708; COR4; PIU19501; PIU19502; PIU19503; PIU19504; PIU19505; PIU19506; PIU19507; PIU19508; PIU19509; PIU195010; PIU195011; PIU195012; PIU195013; PIU195014; COU1; PIC19501; POOUT1; POOUT2; POOUT3; POOUT4; POIN1 (CRNK)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

More accurate threshold for "raw" connection of VR sensors


RES 5; GND(1) 6; GND(2); 7 GND(3); 8 VDD; 9 VDD_IO; INT_2 11; INT_1 12; U106 LIS2DH12TR; VDD 10; INT DRDY; RES 3; Vdd IO 1; GND; LPS22HBTR; ACC_SCK ACC_CS ACC_MISO ACC_MOSI; BARO_SCL BARO_SDA

SCL/SPC 1
SDO/SA0 3
SDA/SDI/SDO 4

SCL/SPC 2
SDO/SA0 5


File: hellen1-vr-max9924.kicad_sch Sheet: /
Id: 1/1 Title: VR MAX9924 module
