P4ulBr4ndt/hellen-bremen/hellenbremen.kicad_pcb

## KiCad design hellenbremen.kicad_pcb (2025-01-02)

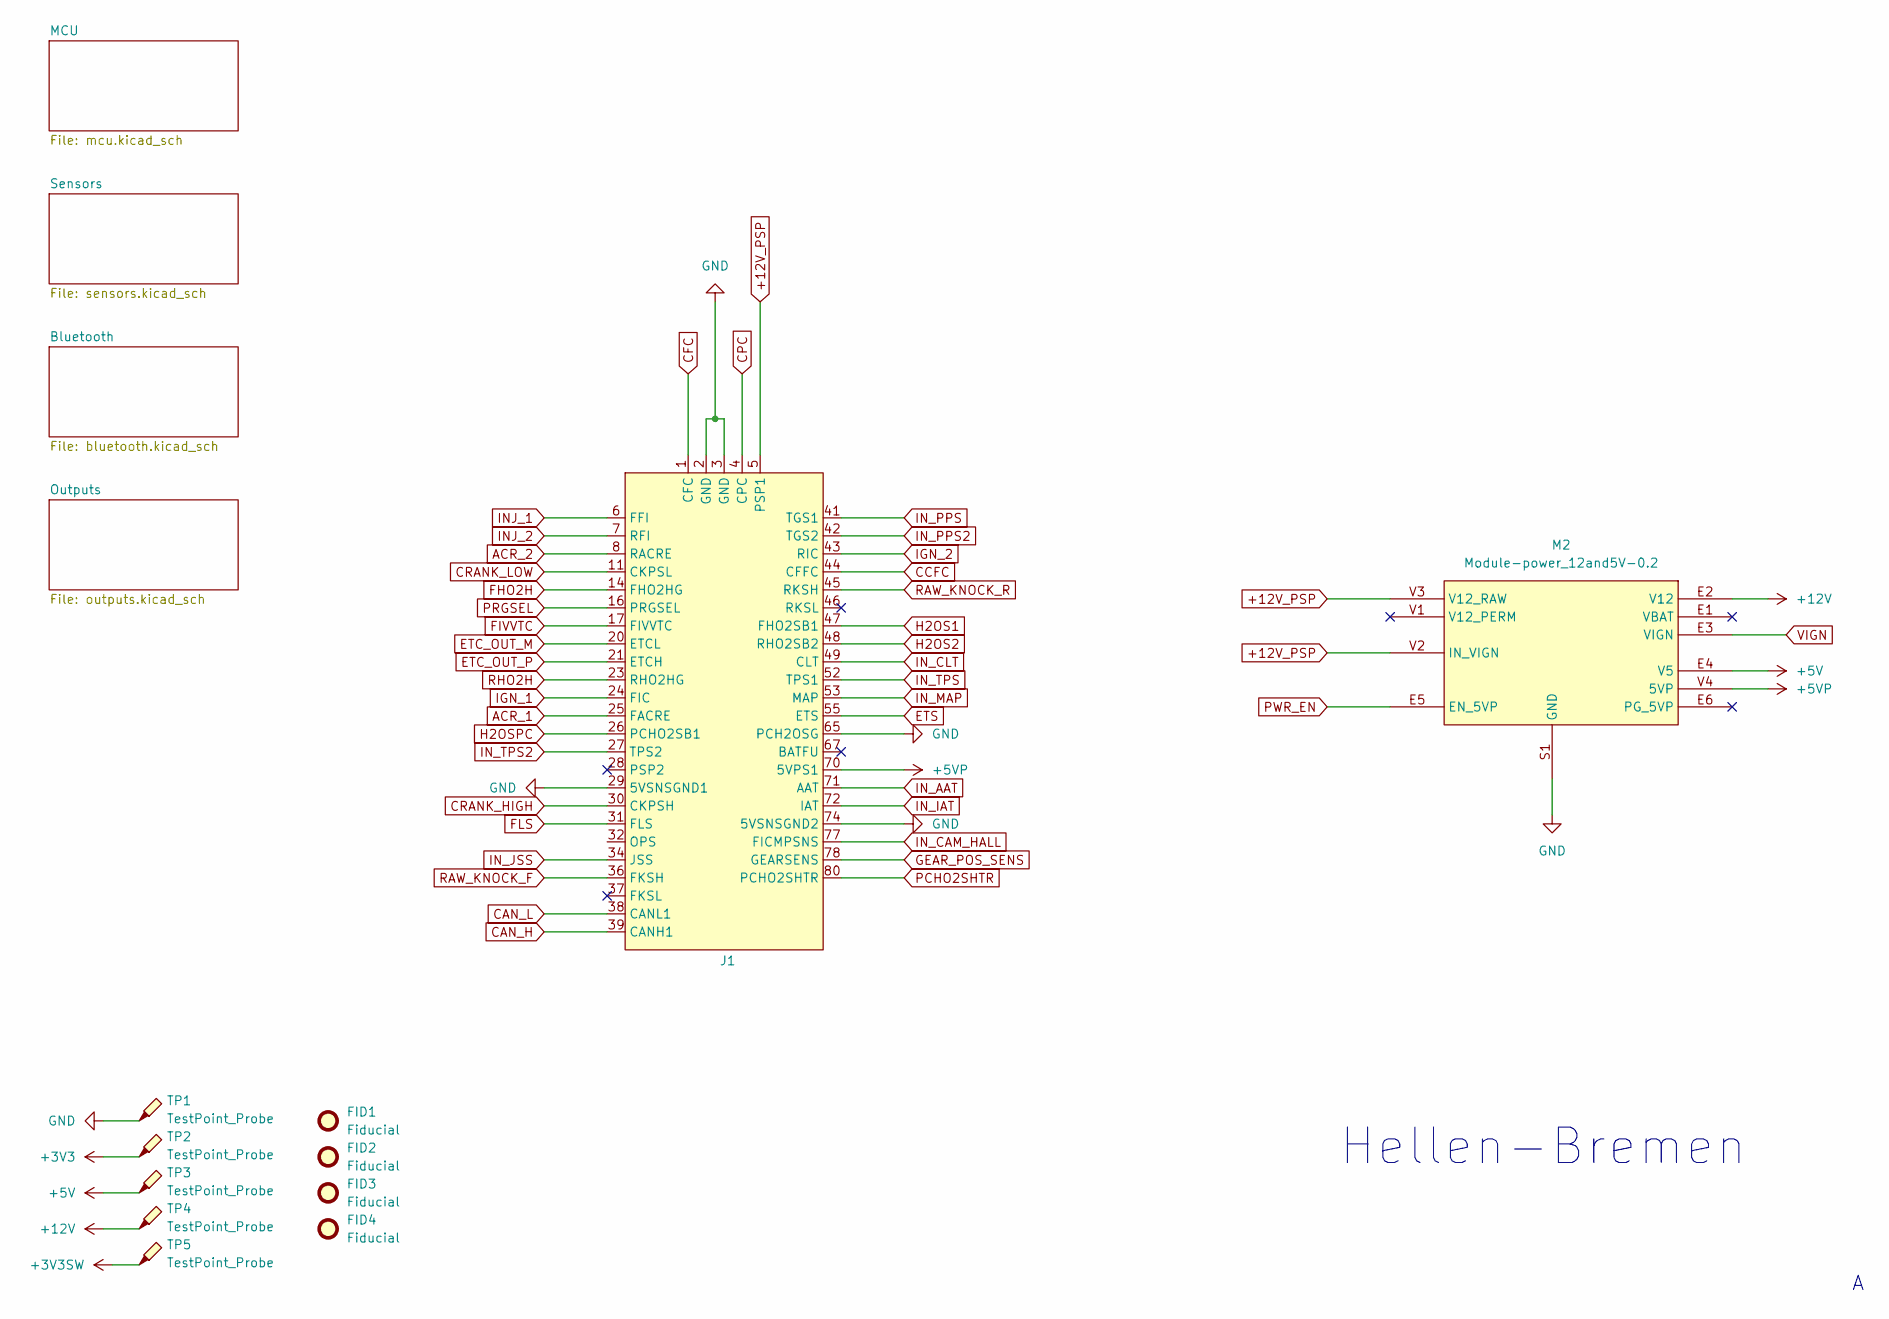
[picture p35: schematic hellenbremen.kicad_sch]

Parts:
FID1, FID2, FID3, FID4: Fiducial; Fiducial_1mm_Mask2mm
J1: HarleyDavidsonDelphi81
M2: Module-power_12and5V-0.2; power_12and5V
TP1, TP2, TP3, TP4, TP5: TestPoint_Probe; TestPoint_Pad_D2.0mm

Connections:
+3V3: TP2.1; also elsewhere on the board
+3V3SW: TP5.1; also elsewhere on the board
+5V: M2.E4 (V5), TP3.1; also elsewhere on the board
+5VP: J1.70 (5VPS1), M2.V4 (5VP)
+12V: M2.E2 (V12), TP4.1; also elsewhere on the board
+12V_PSP: J1.5 (PSP1), M2.V2 (IN_VIGN), M2.V3 (V12_RAW)
ACR_1: J1.25 (FACRE); also elsewhere on the board
ACR_2: J1.8 (RACRE); also elsewhere on the board
CAN_H: J1.39 (CANH1); also elsewhere on the board
CAN_L: J1.38 (CANL1); also elsewhere on the board
CCFC: J1.44 (CFFC); also elsewhere on the board
CFC: J1.1 (CFC); also elsewhere on the board
CPC: J1.4 (CPC); also elsewhere on the board
CRANK_HIGH: J1.30 (CKPSH); also elsewhere on the board
CRANK_LOW: J1.11 (CKPSL); also elsewhere on the board
ETC_OUT_M: J1.20 (ETCL); also elsewhere on the board
ETC_OUT_P: J1.21 (ETCH); also elsewhere on the board
ETS: J1.55 (ETS); also elsewhere on the board
FHO2H: J1.14 (FHO2HG); also elsewhere on the board
FIVVTC: J1.17 (FIVVTC); also elsewhere on the board
FLS: J1.31 (FLS); also elsewhere on the board
GEAR_POS_SENS: J1.78 (GEARSENS); also elsewhere on the board
GND: J1.2 (GND), J1.3 (GND), J1.29 (5VSNSGND1), J1.65 (PCH2OSG), J1.74 (5VSNSGND2), M2.S1 (GND), TP1.1; also elsewhere on the board
H2OS1: J1.47 (FHO2SB1); also elsewhere on the board
H2OS2: J1.48 (RHO2SB2); also elsewhere on the board
H2OSPC: J1.26 (PCHO2SB1); also elsewhere on the board
IGN_1: J1.24 (FIC); also elsewhere on the board
IGN_2: J1.43 (RIC); also elsewhere on the board
INJ_1: J1.6 (FFI); also elsewhere on the board
INJ_2: J1.7 (RFI); also elsewhere on the board
IN_AAT: J1.71 (AAT); also elsewhere on the board
IN_CAM_HALL: J1.77 (FICMPSNS); also elsewhere on the board
IN_CLT: J1.49 (CLT); also elsewhere on the board
IN_IAT: J1.72 (IAT); also elsewhere on the board
IN_JSS: J1.34 (JSS); also elsewhere on the board
IN_MAP: J1.53 (MAP); also elsewhere on the board
IN_PPS: J1.41 (TGS1); also elsewhere on the board
IN_PPS2: J1.42 (TGS2); also elsewhere on the board
IN_TPS: J1.52 (TPS1); also elsewhere on the board
IN_TPS2: J1.27 (TPS2); also elsewhere on the board
PCHO2SHTR: J1.80 (PCHO2SHTR); also elsewhere on the board
PRGSEL: J1.16 (PRGSEL); also elsewhere on the board
PWR_EN: M2.E5 (EN_5VP); also elsewhere on the board
RAW_KNOCK_F: J1.36 (FKSH); also elsewhere on the board
RAW_KNOCK_R: J1.45 (RKSH); also elsewhere on the board
RHO2H: J1.23 (RHO2HG); also elsewhere on the board
VIGN: M2.E3 (VIGN); also elsewhere on the board

Notes on the sheet:
Hellen-Bremen

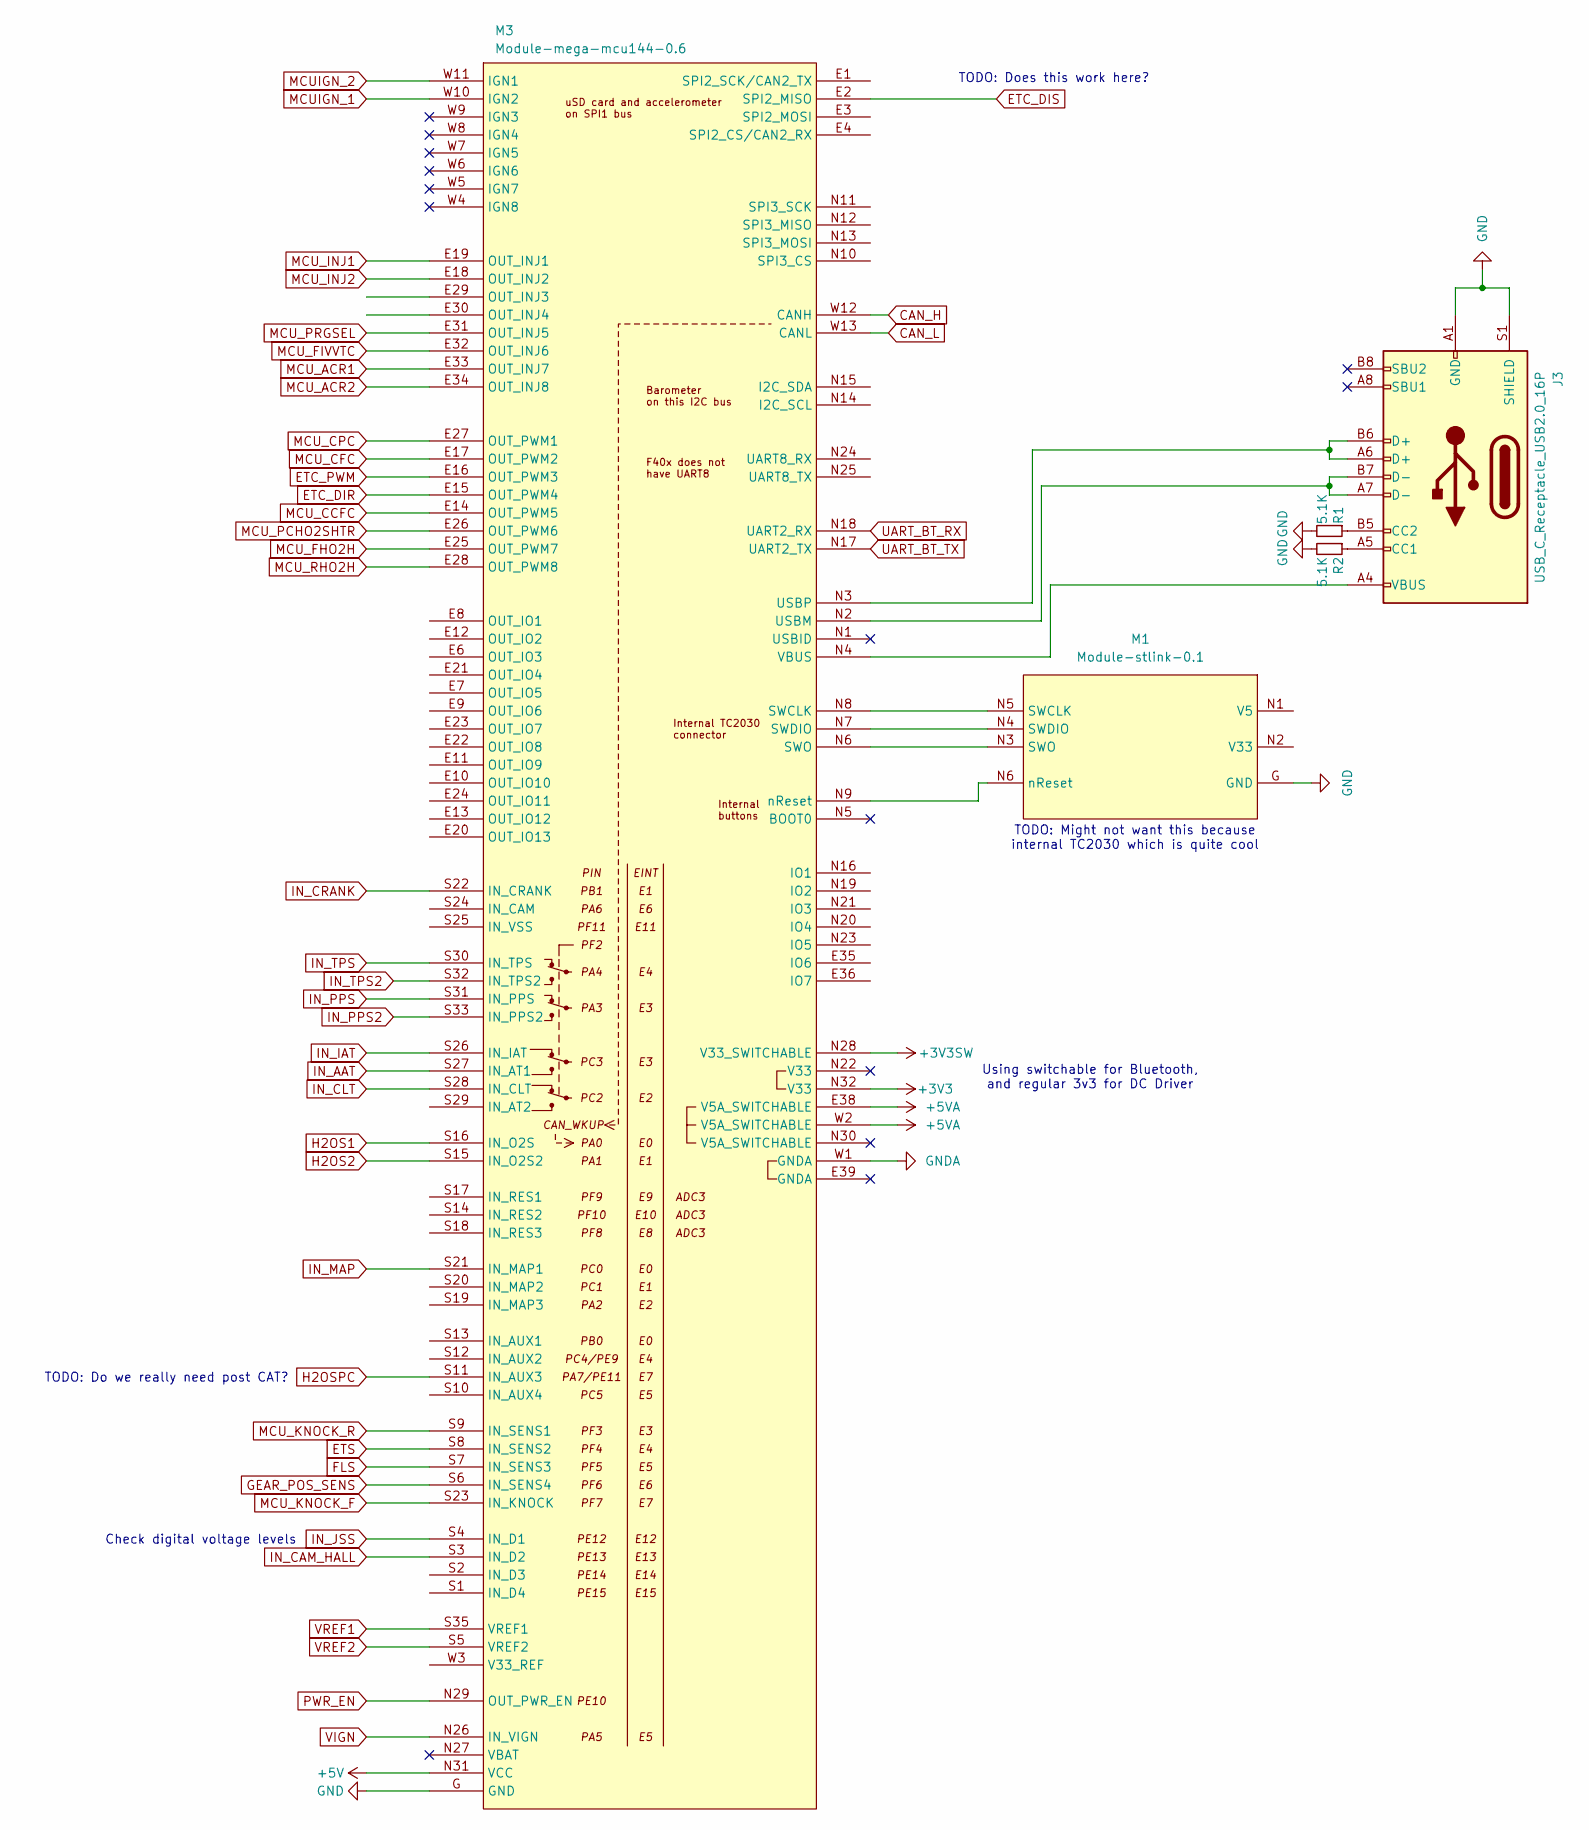
[picture p36: schematic mcu.kicad_sch]

Parts:
J3: USB_C_Receptacle_USB2.0_16P; USB_C_Receptacle_GCT_USB4110
M1: Module-stlink-0.1; stlink
M3: Module-mega-mcu144-0.6; mega-mcu144
R1, R2: 5.1K; R_0402_1005Metric

Connections:
+3V3: M3.N32 (V33); also elsewhere on the board
+3V3SW: M3.N28 (V33_SWITCHABLE); also elsewhere on the board
+5V: M3.N31 (VCC); also elsewhere on the board
+5VA: M3.E38 (V5A_SWITCHABLE), M3.W2 (V5A_SWITCHABLE); also elsewhere on the board
CAN_H: M3.W12 (CANH); also elsewhere on the board
CAN_L: M3.W13 (CANL); also elsewhere on the board
ETC_DIR: M3.E15 (OUT_PWM4); also elsewhere on the board
ETC_DIS: M3.E2 (SPI2_MISO); also elsewhere on the board
ETC_PWM: M3.E16 (OUT_PWM3); also elsewhere on the board
ETS: M3.S8 (IN_SENS2); also elsewhere on the board
FLS: M3.S7 (IN_SENS3); also elsewhere on the board
GEAR_POS_SENS: M3.S6 (IN_SENS4); also elsewhere on the board
GND: J3.A1 (GND), J3.A12 (GND), J3.B1 (GND), J3.B12 (GND), J3.S1 (SHIELD), M1.G (GND), M3.G (GND), R1.2, R2.2; also elsewhere on the board
GNDA: M3.W1 (GNDA)
H2OS1: M3.S16 (IN_O2S); also elsewhere on the board
H2OS2: M3.S15 (IN_O2S2); also elsewhere on the board
H2OSPC: M3.S11 (IN_AUX3); also elsewhere on the board
IN_AAT: M3.S27 (IN_AT1); also elsewhere on the board
IN_CAM_HALL: M3.S3 (IN_D2); also elsewhere on the board
IN_CLT: M3.S28 (IN_CLT); also elsewhere on the board
IN_CRANK: M3.S22 (IN_CRANK); also elsewhere on the board
IN_IAT: M3.S26 (IN_IAT); also elsewhere on the board
IN_JSS: M3.S4 (IN_D1); also elsewhere on the board
IN_MAP: M3.S21 (IN_MAP1); also elsewhere on the board
IN_PPS: M3.S31 (IN_PPS); also elsewhere on the board
IN_PPS2: M3.S33 (IN_PPS2); also elsewhere on the board
IN_TPS: M3.S30 (IN_TPS); also elsewhere on the board
IN_TPS2: M3.S32 (IN_TPS2); also elsewhere on the board
MCUIGN_1: M3.W10 (IGN2); also elsewhere on the board
MCUIGN_2: M3.W11 (IGN1); also elsewhere on the board
MCU_ACR1: M3.E33 (OUT_INJ7); also elsewhere on the board
MCU_ACR2: M3.E34 (OUT_INJ8); also elsewhere on the board
MCU_CCFC: M3.E14 (OUT_PWM5); also elsewhere on the board
MCU_CFC: M3.E17 (OUT_PWM2); also elsewhere on the board
MCU_CPC: M3.E27 (OUT_PWM1); also elsewhere on the board
MCU_FHO2H: M3.E25 (OUT_PWM7); also elsewhere on the board
MCU_FIVVTC: M3.E32 (OUT_INJ6); also elsewhere on the board
MCU_INJ1: M3.E19 (OUT_INJ1); also elsewhere on the board
MCU_INJ2: M3.E18 (OUT_INJ2); also elsewhere on the board
MCU_KNOCK_F: M3.S23 (IN_KNOCK); also elsewhere on the board
MCU_KNOCK_R: M3.S9 (IN_SENS1); also elsewhere on the board
MCU_PCHO2SHTR: M3.E26 (OUT_PWM6); also elsewhere on the board
MCU_PRGSEL: M3.E31 (OUT_INJ5); also elsewhere on the board
MCU_RHO2H: M3.E28 (OUT_PWM8); also elsewhere on the board
unnamed: J3.A5 (CC1), R2.1
unnamed: J3.B5 (CC2), R1.1
unnamed: M1.N5 (SWCLK), M3.N8 (SWCLK)
unnamed: M1.N4 (SWDIO), M3.N7 (SWDIO)
unnamed: M1.N3 (SWO), M3.N6 (SWO)
unnamed: M1.N6 (nReset), M3.N9 (nReset)
unnamed: J3.A7 (D-), J3.B7 (D-), M3.N2 (USBM)
unnamed: J3.A6 (D+), J3.B6 (D+), M3.N3 (USBP)
unnamed: J3.A4 (VBUS), J3.A9 (VBUS), J3.B4 (VBUS), J3.B9 (VBUS), M3.N4 (VBUS)
PWR_EN: M3.N29 (OUT_PWR_EN); also elsewhere on the board
UART_BT_RX: M3.N18 (UART2_RX); also elsewhere on the board
UART_BT_TX: M3.N17 (UART2_TX); also elsewhere on the board
VIGN: M3.N26 (IN_VIGN); also elsewhere on the board
VREF1: M3.S35 (VREF1); also elsewhere on the board
VREF2: M3.S5 (VREF2); also elsewhere on the board

Notes on the sheet:
Using switchable for Bluetooth, and regular 3v3 for DC Driver
TODO: Might not want this because internal TC2030 which is quite cool
TODO: Does this work here?
TODO: Do we really need post CAT?
Check digital voltage levels

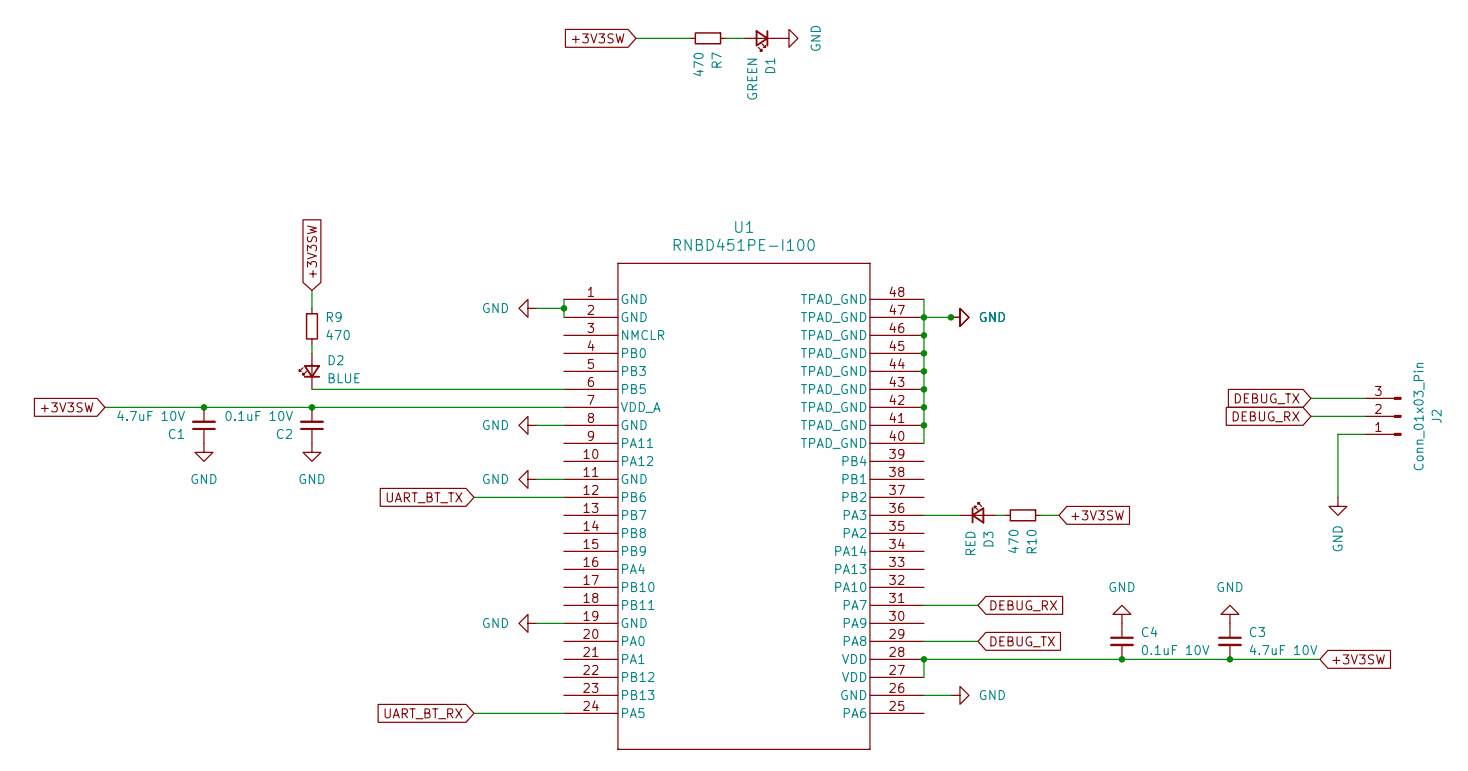
[picture p37: schematic bluetooth.kicad_sch]

Parts:
C1, C3: 4.7uF 10V; C_0603_1608Metric
C2, C4: 0.1uF 10V; C_0402_1005Metric
D1: GREEN; LED_0402_1005Metric
D2: BLUE; LED_0402_1005Metric
D3: RED; LED_0402_1005Metric
J2: Conn_01x03_Pin; PinHeader_1x03_P2.54mm_Vertical
R7, R9, R10: 470; R_0402_1005Metric
U1: RNBD451PE-I100; MOD39_15p5X20p7X2p8_ZSX_MCH

Connections:
+3V3SW: C1.2, C2.2, C3.2, C4.2, R7.2, R9.1, R10.1, U1.7 (VDD_A), U1.27 (VDD), U1.28 (VDD); also elsewhere on the board
DEBUG_RX: J2.2, U1.31 (PA7)
DEBUG_TX: J2.3, U1.29 (PA8)
GND: C1.1, C2.1, C3.1, C4.1, D1.1 (K), J2.1, U1.1 (GND), U1.2 (GND), U1.8 (GND), U1.11 (GND), U1.19 (GND), U1.26 (GND), U1.40 (TPAD_GND), U1.41 (TPAD_GND), U1.42 (TPAD_GND), U1.43 (TPAD_GND), U1.44 (TPAD_GND), U1.45 (TPAD_GND), U1.46 (TPAD_GND), U1.47 (TPAD_GND), U1.48 (TPAD_GND); also elsewhere on the board
unnamed: D1.2 (A), R7.1
unnamed: D2.2 (A), R9.2
unnamed: D2.1 (K), U1.6 (PB5)
unnamed: D3.2 (A), R10.2
unnamed: D3.1 (K), U1.36 (PA3)
UART_BT_RX: U1.24 (PA5); also elsewhere on the board
UART_BT_TX: U1.12 (PB6); also elsewhere on the board

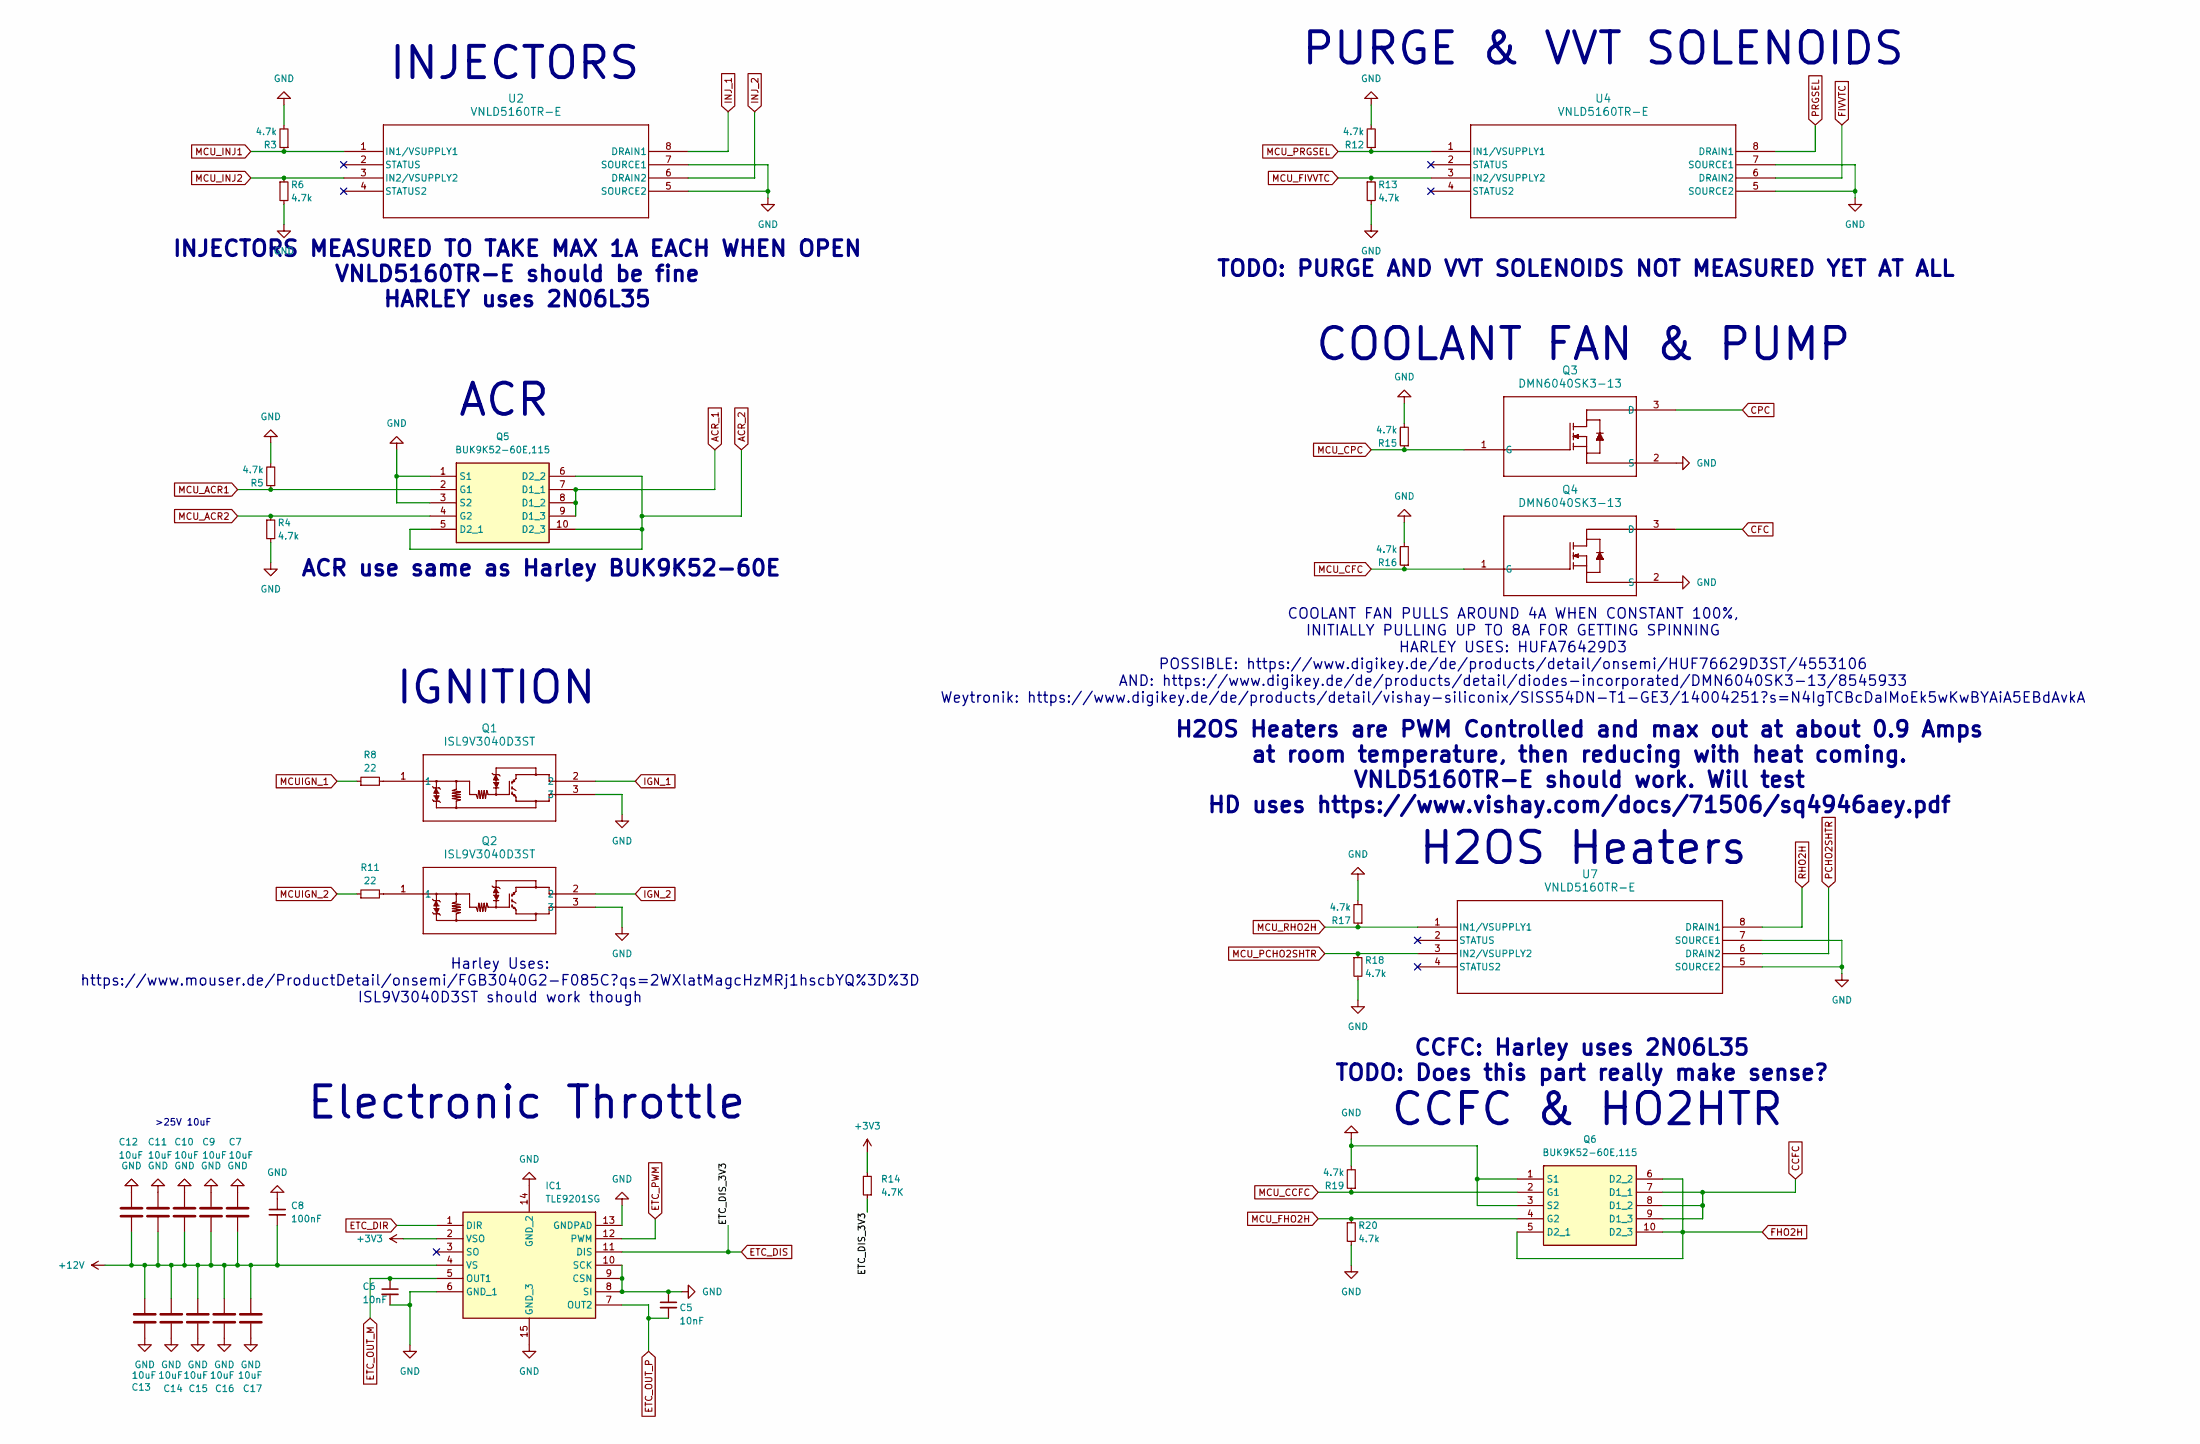
[picture p38: schematic outputs.kicad_sch]

Parts:
C5, C6: 10nF; C_0402_1005Metric
C7, C9, C10, C11, C12, C13, C14, C15, C16, C17: 10uF; C_0805_2012Metric
C8: 100nF; C_0603_1608Metric
IC1: TLE9201SG; Mouser Part Number 726-TLE9201SG
Q1, Q2: ISL9V3040D3ST; TO-252AA_ONS
Q3, Q4: DMN6040SK3-13; D-PAK_DMN6040SK3-13_DIO
Q5, Q6: BUK9K52-60E,115; BUK7K6R840E115; Mouser Part Number 771-BUK9K52-60E115
R3, R4, R5, R6, R12, R13, R15, R16, R17, R18, R19, R20: 4.7k; R_0402_1005Metric
R8, R11: 22; R_0603_1608Metric
R14: 4.7K; R_0402_1005Metric
U2, U4, U7: VNLD5160TR-E; SO_160TR-E_STM

Connections:
+3V3: IC1.2 (VSO), R14.2; also elsewhere on the board
+12V: C7.2, C8.2, C9.2, C10.2, C11.2, C12.2, C13.2, C14.2, C15.2, C16.2, C17.2, IC1.4 (VS); also elsewhere on the board
ACR_1: Q5.7 (D1_1), Q5.8 (D1_2), Q5.9 (D1_3); also elsewhere on the board
ACR_2: Q5.5 (D2_1), Q5.6 (D2_2), Q5.10 (D2_3); also elsewhere on the board
CCFC: Q6.7 (D1_1), Q6.8 (D1_2), Q6.9 (D1_3); also elsewhere on the board
CFC: Q4.3 (D); also elsewhere on the board
CPC: Q3.3 (D); also elsewhere on the board
ETC_DIR: IC1.1 (DIR); also elsewhere on the board
ETC_DIS: IC1.11 (DIS), R14.1; also elsewhere on the board
ETC_OUT_M: C6.1, IC1.5 (OUT1); also elsewhere on the board
ETC_OUT_P: C5.2, IC1.7 (OUT2); also elsewhere on the board
ETC_PWM: IC1.12 (PWM); also elsewhere on the board
FHO2H: Q6.5 (D2_1), Q6.6 (D2_2), Q6.10 (D2_3); also elsewhere on the board
FIVVTC: U4.6 (DRAIN2); also elsewhere on the board
GND: C5.1, C6.2, C7.1, C8.1, C9.1, C10.1, C11.1, C12.1, C13.1, C14.1, C15.1, C16.1, C17.1, IC1.6 (GND_1), IC1.8 (SI), IC1.9 (CSN), IC1.10 (SCK), IC1.13 (GNDPAD), IC1.14 (GND_2), IC1.15 (GND_3), Q1.3, Q2.3, Q3.2 (S), Q4.2 (S), Q5.1 (S1), Q5.3 (S2), Q6.1 (S1), Q6.3 (S2), R3.2, R4.2, R5.2, R6.2, R12.2, R13.2, R15.2, R16.2, R17.2, R18.2, R19.2, R20.2, U2.5 (SOURCE2), U2.7 (SOURCE1), U4.5 (SOURCE2), U4.7 (SOURCE1), U7.5 (SOURCE2), U7.7 (SOURCE1); also elsewhere on the board
IGN_1: Q1.2; also elsewhere on the board
IGN_2: Q2.2; also elsewhere on the board
INJ_1: U2.8 (DRAIN1); also elsewhere on the board
INJ_2: U2.6 (DRAIN2); also elsewhere on the board
MCUIGN_1: R8.1; also elsewhere on the board
MCUIGN_2: R11.1; also elsewhere on the board
MCU_ACR1: Q5.2 (G1), R5.1; also elsewhere on the board
MCU_ACR2: Q5.4 (G2), R4.1; also elsewhere on the board
MCU_CCFC: Q6.2 (G1), R19.1; also elsewhere on the board
MCU_CFC: Q4.1 (G), R16.1; also elsewhere on the board
MCU_CPC: Q3.1 (G), R15.1; also elsewhere on the board
MCU_FHO2H: Q6.4 (G2), R20.1; also elsewhere on the board
MCU_FIVVTC: R13.1, U4.3 (IN2/VSUPPLY2); also elsewhere on the board
MCU_INJ1: R3.1, U2.1 (IN1/VSUPPLY1); also elsewhere on the board
MCU_INJ2: R6.1, U2.3 (IN2/VSUPPLY2); also elsewhere on the board
MCU_PCHO2SHTR: R18.1, U7.3 (IN2/VSUPPLY2); also elsewhere on the board
MCU_PRGSEL: R12.1, U4.1 (IN1/VSUPPLY1); also elsewhere on the board
MCU_RHO2H: R17.1, U7.1 (IN1/VSUPPLY1); also elsewhere on the board
unnamed: Q1.1, R8.2
unnamed: Q2.1, R11.2
PCHO2SHTR: U7.6 (DRAIN2); also elsewhere on the board
PRGSEL: U4.8 (DRAIN1); also elsewhere on the board
RHO2H: U7.8 (DRAIN1); also elsewhere on the board

Notes on the sheet:
COOLANT FAN PULLS AROUND 4A WHEN CONSTANT 100%, INITIALLY PULLING UP TO 8A FOR GETTING SPINNING HARLEY USES: HUFA76429D3 POSSIBLE: https://www.digikey.de/de/products/detail/onsemi/HUF76629D3ST/4553106 AND: https://www.digikey.de/de/products/detail/diodes-incorporated/DMN6040SK3-13/8545933 Weytronik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
PURGE & VVT SOLENOIDS
INJECTORS MEASURED TO TAKE MAX 1A EACH WHEN OPEN VNLD5160TR-E should be fine HARLEY uses 2N06L35
INJECTORS
H2OS Heaters are PWM Controlled and max out at about 0.9 Amps at room temperature, then reducing with heat coming. VNLD5160TR-E should work. Will test HD uses https://www.vishay.com/docs/71506/sq4946aey.pdf
TODO: PURGE AND VVT SOLENOIDS NOT MEASURED YET AT ALL
ACR
Harley Uses: https://www.mouser.de/ProductDetail/onsemi/FGB3040G2-F085C?qs=2WXlatMagcHzMRj1hscbYQ%3D%3D ISL9V3040D3ST should work though
>25V 10uF
COOLANT FAN & PUMP
IGNITION
ACR use same as Harley BUK9K52-60E
Electronic Throttle
CCFC & HO2HTR
H2OS Heaters
CCFC: Harley uses 2N06L35 TODO: Does this part really make sense?

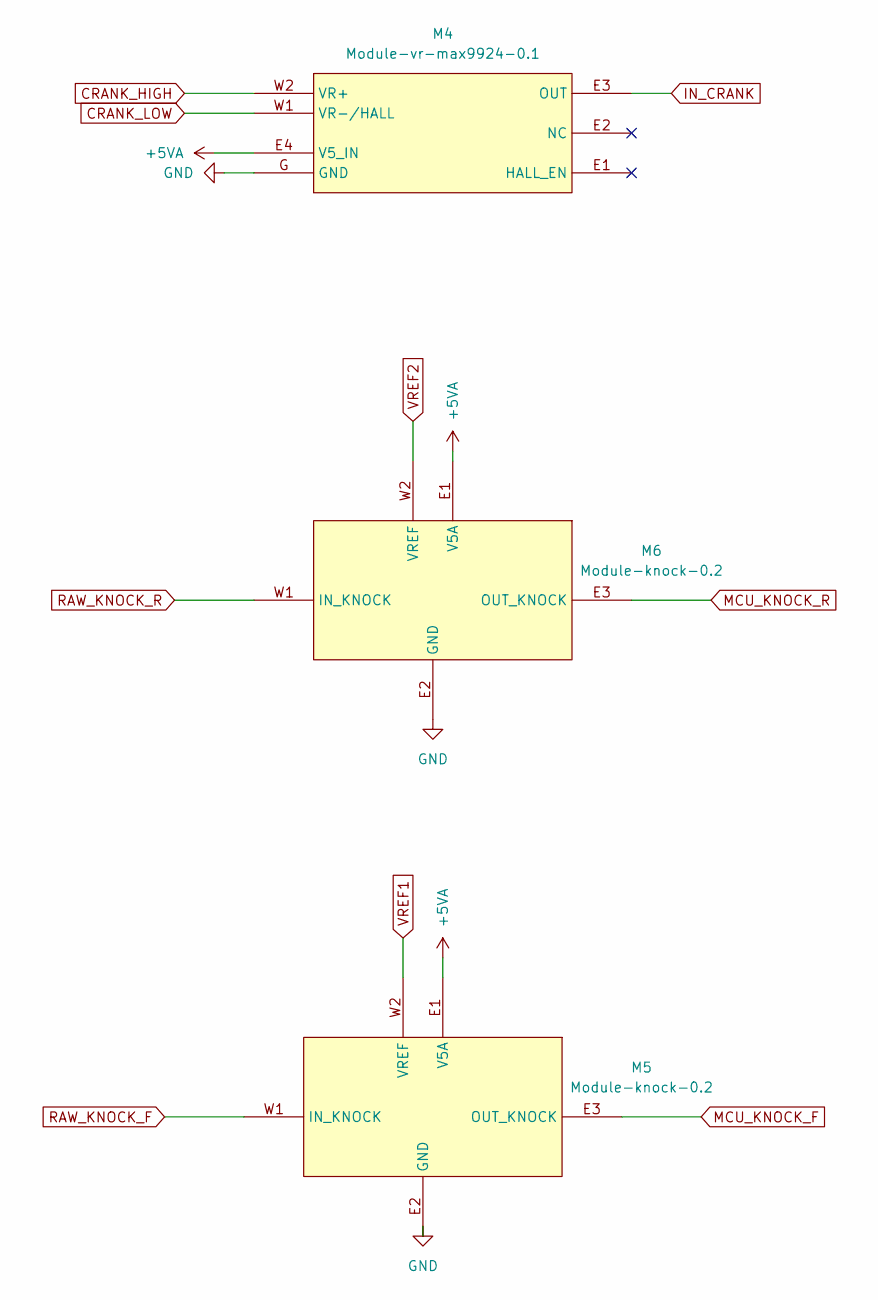
[picture p39: schematic sensors.kicad_sch]

Parts:
M4: Module-vr-max9924-0.1; vr-max9924
M5, M6: Module-knock-0.2; knock

Connections:
+5VA: M4.E4 (V5_IN), M5.E1 (V5A), M6.E1 (V5A); also elsewhere on the board
CRANK_HIGH: M4.W2 (VR+); also elsewhere on the board
CRANK_LOW: M4.W1 (VR-/HALL); also elsewhere on the board
GND: M4.G (GND), M5.E2 (GND), M6.E2 (GND); also elsewhere on the board
IN_CRANK: M4.E3 (OUT); also elsewhere on the board
MCU_KNOCK_F: M5.E3 (OUT_KNOCK); also elsewhere on the board
MCU_KNOCK_R: M6.E3 (OUT_KNOCK); also elsewhere on the board
RAW_KNOCK_F: M5.W1 (IN_KNOCK); also elsewhere on the board
RAW_KNOCK_R: M6.W1 (IN_KNOCK); also elsewhere on the board
VREF1: M5.W2 (VREF); also elsewhere on the board
VREF2: M6.W2 (VREF); also elsewhere on the board

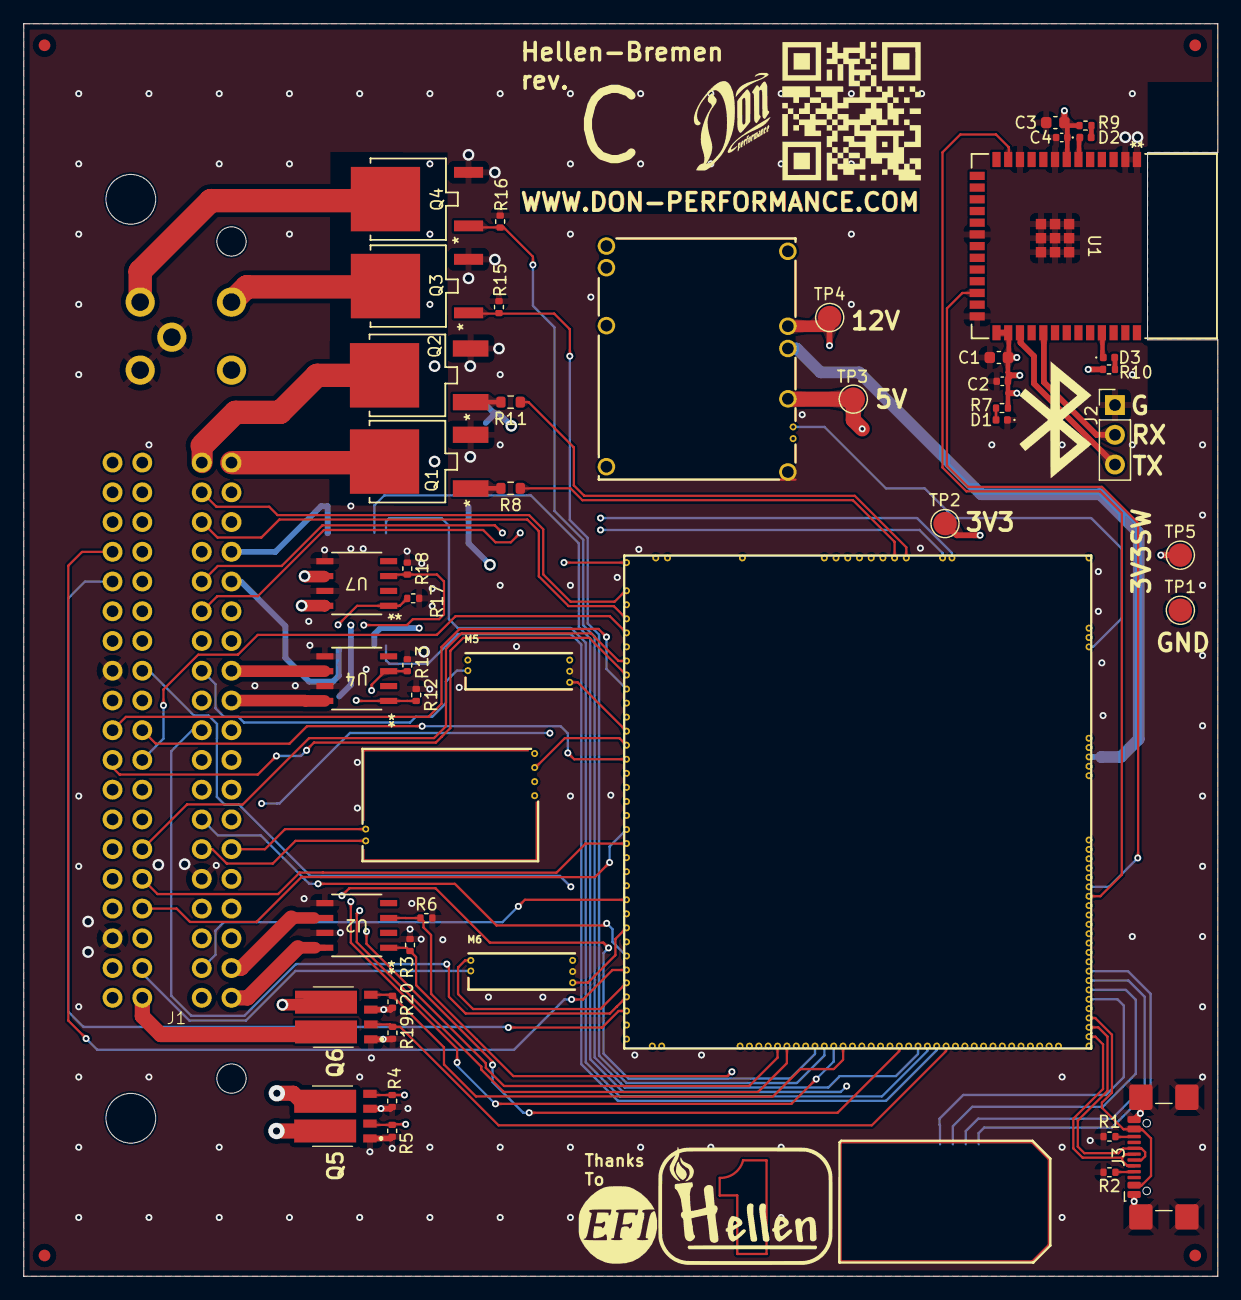
[picture p40: board hellenbremen.kicad_pcb from above]

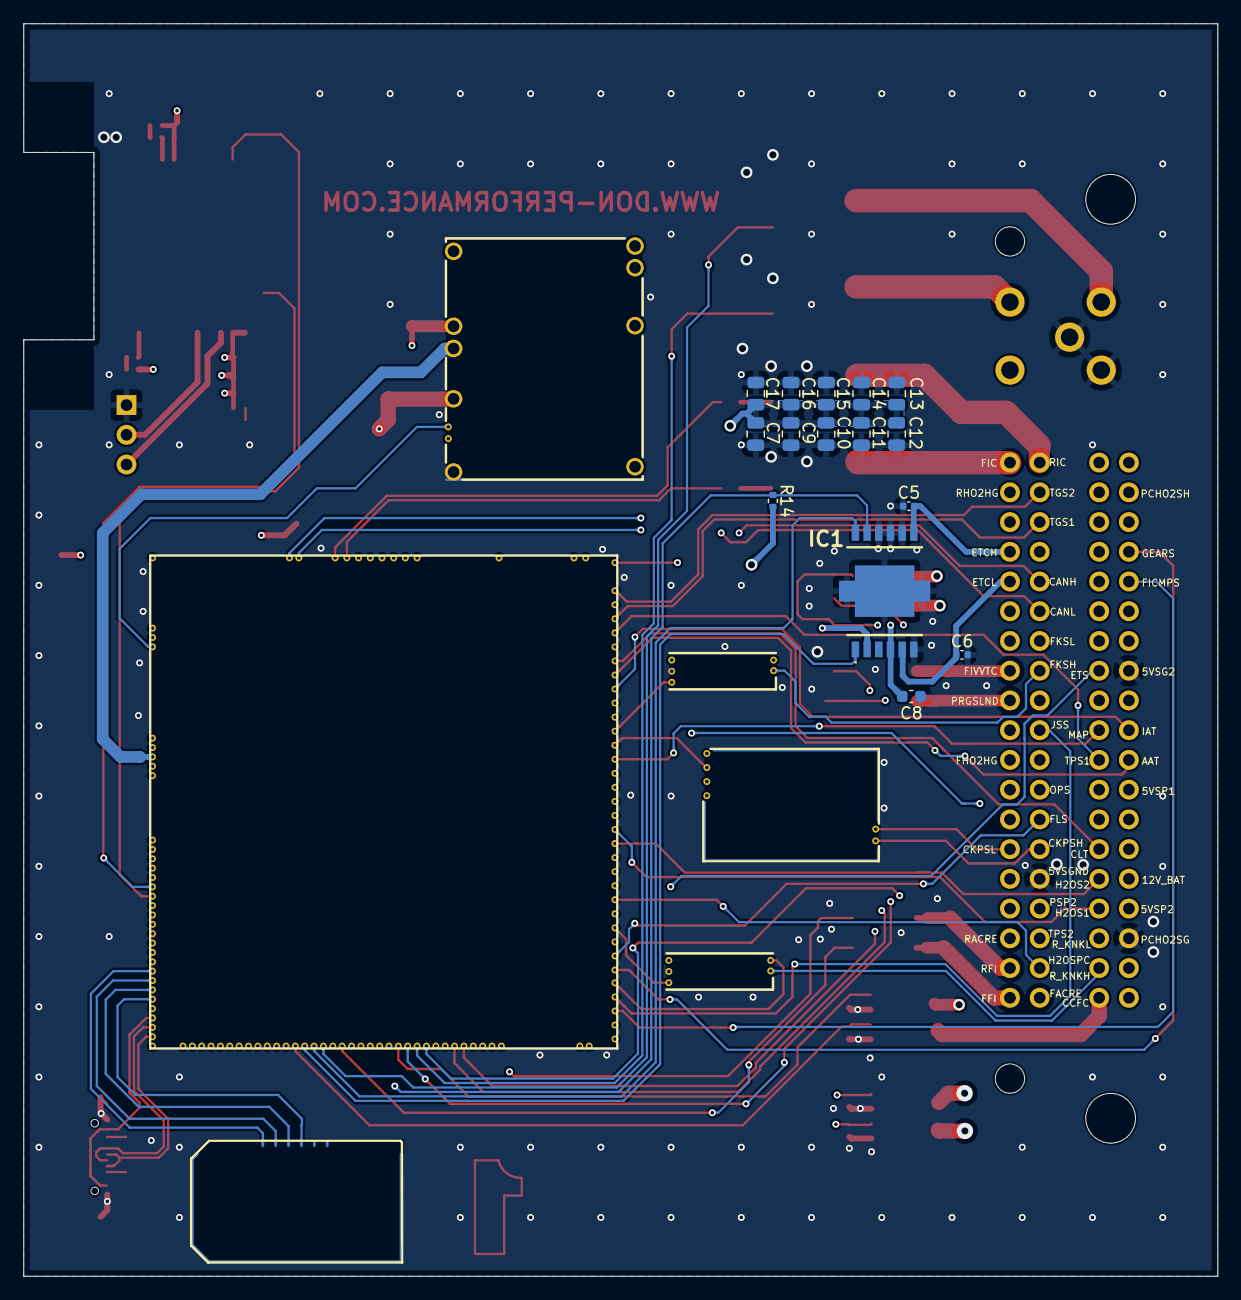
[picture p41: board hellenbremen.kicad_pcb from below]

Board: 4 copper layers, 102.0 x 107.0 mm, 69 parts (15 on the bottom side), 90 nets.
