P4ulBr4ndt/hellen-bremen/(commit log)

2024-11-14 adding first sheets
    [WBZ451_LGA_REV3P0-WOUFL.step, bluetooth.kicad_sch, hellenbremen.kicad_pcb, hellenbremen.kicad_sch, mcu.kicad_sch, power.kicad_sch, sensors.kicad_sch]
2024-11-14 adding aux_axis_origin
    [hellenbremen.kicad_pcb]
2024-11-14 [skip actions] Auto-generated board v2.1
    [hellenbremen-B_Cu.gbl, hellenbremen-B_Mask.gbs, hellenbremen-B_Paste.gbp, hellenbremen-B_Silkscreen.gbo, hellenbremen-Edge_Cuts.gm1, hellenbremen-F_Cu.gtl, hellenbremen-F_Mask.gts, hellenbremen-F_Paste.gtp]
2024-11-14 bom replace file
    [bom_replace_hellenbremen-a.csv]
2024-11-14 moving origin to bottom left
    [hellenbremen.kicad_pcb]
2024-11-14 trying to fix aligment
    [hellenbremen.kicad_pcb, mcu.kicad_sch, power.kicad_sch]
2024-11-16 Implementing some inputs and outputs
    [DPAK_VND3_STM.step, SO_160TR-E_STM.step, hellenbremen.kicad_pcb, hellenbremen.kicad_sch, mcu.kicad_sch, outputs.kicad_sch, power.kicad_sch, sensors.kicad_sch]
2024-11-16 still initial layout
    [bluetooth.kicad_sch, hellenbremen.kicad_pcb, hellenbremen.kicad_sch, mcu.kicad_sch, outputs.kicad_sch]
2024-11-17 igntion igbt, cooling mosfet
    [bluetooth.kicad_sch, hellenbremen.kicad_pcb, hellenbremen.kicad_sch, mcu.kicad_sch, outputs.kicad_sch]
2024-11-19 trying out a layout and routing
    [hellenbremen.kicad_pcb, hellenbremen.kicad_sch, mcu.kicad_sch, power.kicad_sch, sensors.kicad_sch]
2024-11-19 more silkscreen pin markings, thicker power and ignition traces
    [hellenbremen.kicad_pcb]
2024-11-19 renaming graphics reference
    [hellenbremen.kicad_pcb]
2024-11-19 Setting exclude from bom property
    [hellenbremen.kicad_pcb]
2024-11-20 interconnected isolated grounds, minor routing changes
    [hellenbremen.kicad_pcb]
2024-11-20 Fiducial Marks and Via Stitching
    [hellenbremen.kicad_pcb, hellenbremen.kicad_sch]
2024-11-20 Trying to fix yet another XY is not in BOM File error
    [hellenbremen.kicad_pcb]
2024-11-20 adding electronic throttle control
    [DPAK_VND3_STM.step, TLE9201SG.stp, TO252-DPAK.STP, hellenbremen.kicad_pcb, hellenbremen.kicad_sch, mcu.kicad_sch, outputs.kicad_sch]
2024-11-22 adding most remaining outputs and sensors like vvt, cam etc
    [hellenbremen.kicad_pcb, hellenbremen.kicad_sch, mcu.kicad_sch, outputs.kicad_sch, sensors.kicad_sch]
2024-11-22 J1 not in BOM
    [hellenbremen.kicad_pcb]
2024-11-24 redone layout, possibly feature complete
    [hellenbremen.kicad_pcb, hellenbremen.kicad_sch, mcu.kicad_sch, outputs.kicad_sch, power.kicad_sch, sensors.kicad_sch]
2024-11-25 Proper stronger mosfet for coolant fan and pump
    [hellenbremen.kicad_pcb, outputs.kicad_sch]
2024-11-26 pwm for heaters, minor routing and via changes, teardrops
    [hellenbremen.kicad_pcb, mcu.kicad_sch, outputs.kicad_sch]
2024-11-26 large cap, more silkscreen for big connector
    [bluetooth.kicad_sch, hellenbremen.kicad_pcb, outputs.kicad_sch]
2024-11-26 removed unwanted via
    [hellenbremen.kicad_pcb]
2024-11-26 trying to get rid of broken line in position file
    [hellenbremen.kicad_pcb]
2024-11-26 ACR mosfet
    [hellenbremen.kicad_pcb, outputs.kicad_sch]
2024-11-26 some documentation and etc_dir added
    [hellenbremen.kicad_pcb, mcu.kicad_sch, outputs.kicad_sch]
2024-11-28 update main connector footprint
    [bluetooth.kicad_sch, hellenbremen.kicad_pcb, hellenbremen.kicad_sch, outputs.kicad_sch]
2024-11-29 ccfc mosfet and power changes
    [hellenbremen.kicad_pcb, hellenbremen.kicad_sch, outputs.kicad_sch]
2024-12-01 less clearance gnd stitching
    [hellenbremen.kicad_pcb]
2024-12-02 no perm 12V and minor routing
    [hellenbremen.kicad_pcb, hellenbremen.kicad_sch]
2024-12-18 revision B, stronger THT rings
    [hellenbremen.kicad_pcb]
2024-12-18 J1 once again
    [hellenbremen.kicad_pcb]
2024-12-18 replace file
    [bom_replace_hellenbremen-b.csv]
2024-12-18 revision code silkscreen
    [hellenbremen.kicad_pcb]
2025-01-02 revision c removing unwanted paste contents
    [bom_replace_hellenbremen-c.csv, hellenbremen.kicad_pcb]
